AleksandreKalandadze/GateWay_STM32/GateWay_ver_2_3/Datasheets/POE pinout.png

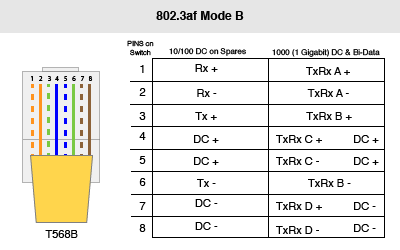
GateWay_ver_2_3/Datasheets/POE pinout.png
