AleksandreKalandadze/GateWay_STM32/GateWay_ver_2_3/Datasheets/W5500-Schematics.png

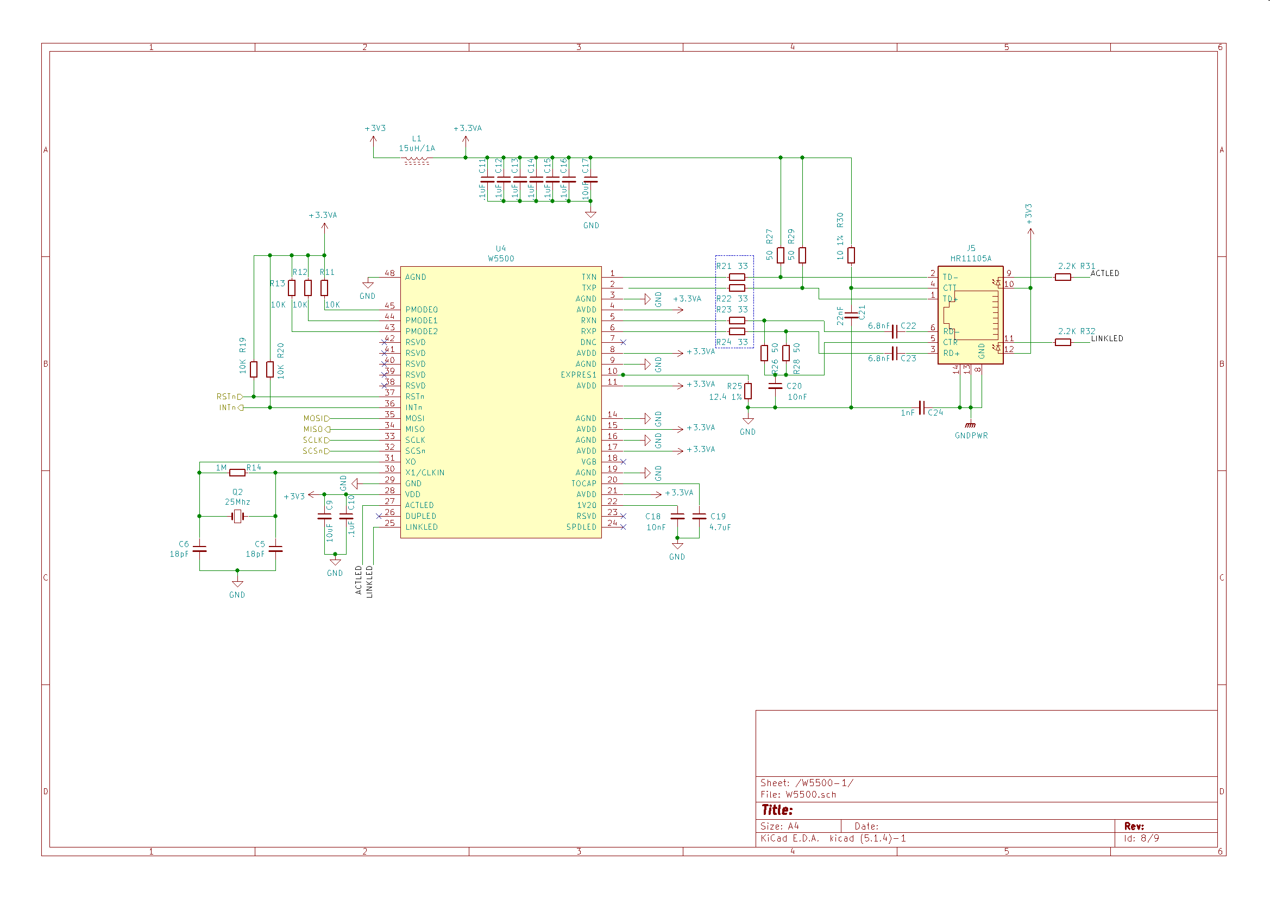
GateWay_ver_2_3/Datasheets/W5500-Schematics.png
