AleksandreKalandadze/GateWay_STM32/GateWay_ver_2_3/Parts/parts.xlsx

v AE1, AE2 | Antenna_Shield | Connector_Coaxial:SMA_Amphenol_901-144_Vertical
AE1 | Antenna_Shield | Connector_Coaxial:SMA_Amphenol_901-144_Vertical
AE2 | Antenna_Shield | Connector_Coaxial:SMA_Amphenol_901-144_Vertical
> C1-C5, C8, C17, C19-C22, C24-C27, C30, C31 | 100uF | Capacitor_SMD:C_1210_3225Metric
> C10, C50, C76, C83, C92 | 4.7uF | Capacitor_SMD:C_0805_2012Metric
C11 | 100uF tant | Capacitor_Tantalum_SMD:CP_EIA-3216-18_Kemet-A
> C7, C9, C12, C13, C16, C29, C32-C35, C38, C40, C43-C46, C48, C51, C52, C54, C56, C64, C65, C68-C73, C75, C79, C84-C90, C93-C96, C99, C100 | 0.1uF | Capacitor_SMD:C_0603_1608Metric
> C14, C15, C42, C47, C49, C53, C74, C78 | 0.01uF | Capacitor_SMD:C_0603_1608Metric
> C18, C23, C28, C36, C37, C67 | 22pF | Capacitor_SMD:C_0603_1608Metric
> C39, C41 | 2.2uF | Capacitor_SMD:C_0805_2012Metric
> C61, C62 | 10pF | Capacitor_SMD:C_0603_1608Metric
C63 | 1.5F | Capacitor_THT:C_Rect_L7.5mm_W6.5mm_P5.00mm
C66 | 18pF | Capacitor_SMD:C_0603_1608Metric
> C80, C81 | 6.8nF | Capacitor_SMD:C_0603_1608Metric
> C57, C77, C82 | 10uF | Capacitor_SMD:C_0805_2012Metric
C91 | 22nF | Capacitor_SMD:C_0603_1608Metric
D3 | MMBZ5242BLT3G | Package_TO_SOT_SMD:SOT-23
D7 | SMF15C | Package_TO_SOT_SMD:SOT-363_SC-70-6_Handsoldering
> D1, D8 | SMAJ5.0CA | Diode_SMD:D_SMA
> D6, D9-D17, D22 | LED_GREEN | LED_SMD:LED_0603_1608Metric
> D4, D5, D18, D19 | 1N5819 | Footprint:SOD-323
D20 | SM712_SOT23 | Package_TO_SOT_SMD:SOT-23
> D2, D21 | LED_RED | LED_SMD:LED_0603_1608Metric
J1 | DC-Jack_2.5x5.5 | Footprint:DC_Jack
J2 | SIM_Card | Footprint:SIM_Card_Holder_Molex
> J3, J4 | Conn_01x04 | Connector_PinHeader_1.27mm:PinHeader_1x04_P1.27mm_Vertical
J5 | Micro_SD_Card | Footprint:SD_Card_Holder_1
J6 | Conn_02x10_Odd_Even | Connector_IDC:IDC-Header_2x10_P2.54mm_Vertical
J7 | HR911105A | Footprint:HANRUN_HR911105A
> J8-J10 | RJ45_LED_Shielded | Connector_RJ:RJ45_Amphenol_RJHSE538X
J11 | Conn_01x05 | Footprint:XH2.54_4P_SMD
J12 | USB_B_Mini | Connector_USB:USB_Mini-B_Lumberg_2486_01_Horizontal
L1 | 4.7uH | Footprint:CD43
L2 | 6.8uH | Footprint:CD43
L3 | 47nH | Inductor_SMD:L_0805_2012Metric
L4 | 15uH | Resistor_SMD:R_0603_1608Metric
> Q1, Q4 | AO3400 | Package_TO_SOT_SMD:SOT-23
Q2 | DMP3013SFV | Package_SON:Diodes_PowerDI3333-8
Q3 | MMBT3904 | Package_TO_SOT_SMD:SOT-23
R12 | 100k | Resistor_SMD:R_0603_1608Metric
> R4, R13, R14 | 47k | Resistor_SMD:R_0603_1608Metric
> R15, R18 | 62k | Resistor_SMD:R_0603_1608Metric
R16 | 18k | Resistor_SMD:R_0603_1608Metric
R17 | 1.6k | Resistor_SMD:R_0603_1608Metric
> R5, R19 | 12k | Resistor_SMD:R_0603_1608Metric
> R21-R23 | 22R | Resistor_SMD:R_0603_1608Metric
> R10, R25-R29, R31, R55, R56, R61, R65, R72, R73, R81, R82 | 10k | Resistor_SMD:R_0603_1608Metric
R32 | 4.7 | Resistor_SMD:R_0603_1608Metric
> R6, R20, R24, R33, R68, R70 | 510R | Resistor_SMD:R_0603_1608Metric
R42 | 200R | Resistor_SMD:R_1206_3216Metric
> R1-R3, R7-R9, R11, R44, R46 | 4.7k | Resistor_SMD:R_0603_1608Metric
R47 | 1M | Resistor_SMD:R_0603_1608Metric
> R51-R54 | 33R | Resistor_SMD:R_0603_1608Metric
> R57-R60 | 49R | Resistor_SMD:R_0603_1608Metric
R62 | 12.4k 1% | Resistor_SMD:R_0603_1608Metric
> R30, R34-R41, R43, R45, R48-R50, R63, R66, R67, R71, R74-R80 | 1k | Resistor_SMD:R_0603_1608Metric
R64 | 10R | Resistor_SMD:R_0603_1608Metric
R69 | 120R | Resistor_SMD:R_0603_1608Metric
> SW1, SW2 | SW_Push | Button_Switch_SMD:SW_SPST_CK_RS282G05A3
> U1, U2 | RT8259 | Package_TO_SOT_SMD:SOT-23-6_Handsoldering
U3 | MIC29302WU | Package_TO_SOT_SMD:TO-263-5_TabPin3
U4 | ESP32-WROOM-32D | Footprint:ESP32-WROOM-32D
U5 | SIM7600E-H | Footprint:SIM7600E-H
U6 | HC-05 | Footprint:HC-05
U7 | STM32F407VETx | Package_QFP:LQFP-100_14x14mm_P0.5mm
U8 | PCF85063AT | Package_SO:SOIC-8_3.9x4.9mm_P1.27mm
U9 | CAT24C256 | Package_SO:SOIC-8_3.9x4.9mm_P1.27mm
U10 | TMP100 | Package_TO_SOT_SMD:SOT-23-6
U11 | W5500 | Package_QFP:LQFP-48_7x7mm_P0.5mm
U12 | SN74LV4052APW | Package_SO:TSSOP-16_4.4x5mm_P0.65mm
U13 | MAX3232 | Package_SO:SOP-16_3.9x9.9mm_P1.27mm
U14 | FT232RL | Package_SO:SSOP-28_5.3x10.2mm_P0.65mm
U15 | MAX3485 | Package_SO:SOIC-8_3.9x4.9mm_P1.27mm
U16 | TPD4EUSB30 | Package_SON:USON-10_2.5x1.0mm_P0.5mm
Y1 | 8mhz | Footprint:Crystal_smd_3225
Y2 | Crystal_GND23 | Crystal:Crystal_SMD_SeikoEpson_MC306-4Pin_8.0x3.2mm
Y3 | 25mhz | Footprint:Crystal_smd_3225
