AleksandreKalandadze/GateWay_STM32/GateWay_ver_2_3/PCB/Gateway_STM32_ver_2_3/COM PORT & BLE.kicad_sch

## KiCad design GateWay_ver_2_3/PCB/Gateway_STM32_ver_2_3/COM PORT & BLE.kicad_sch (2022-05-21)

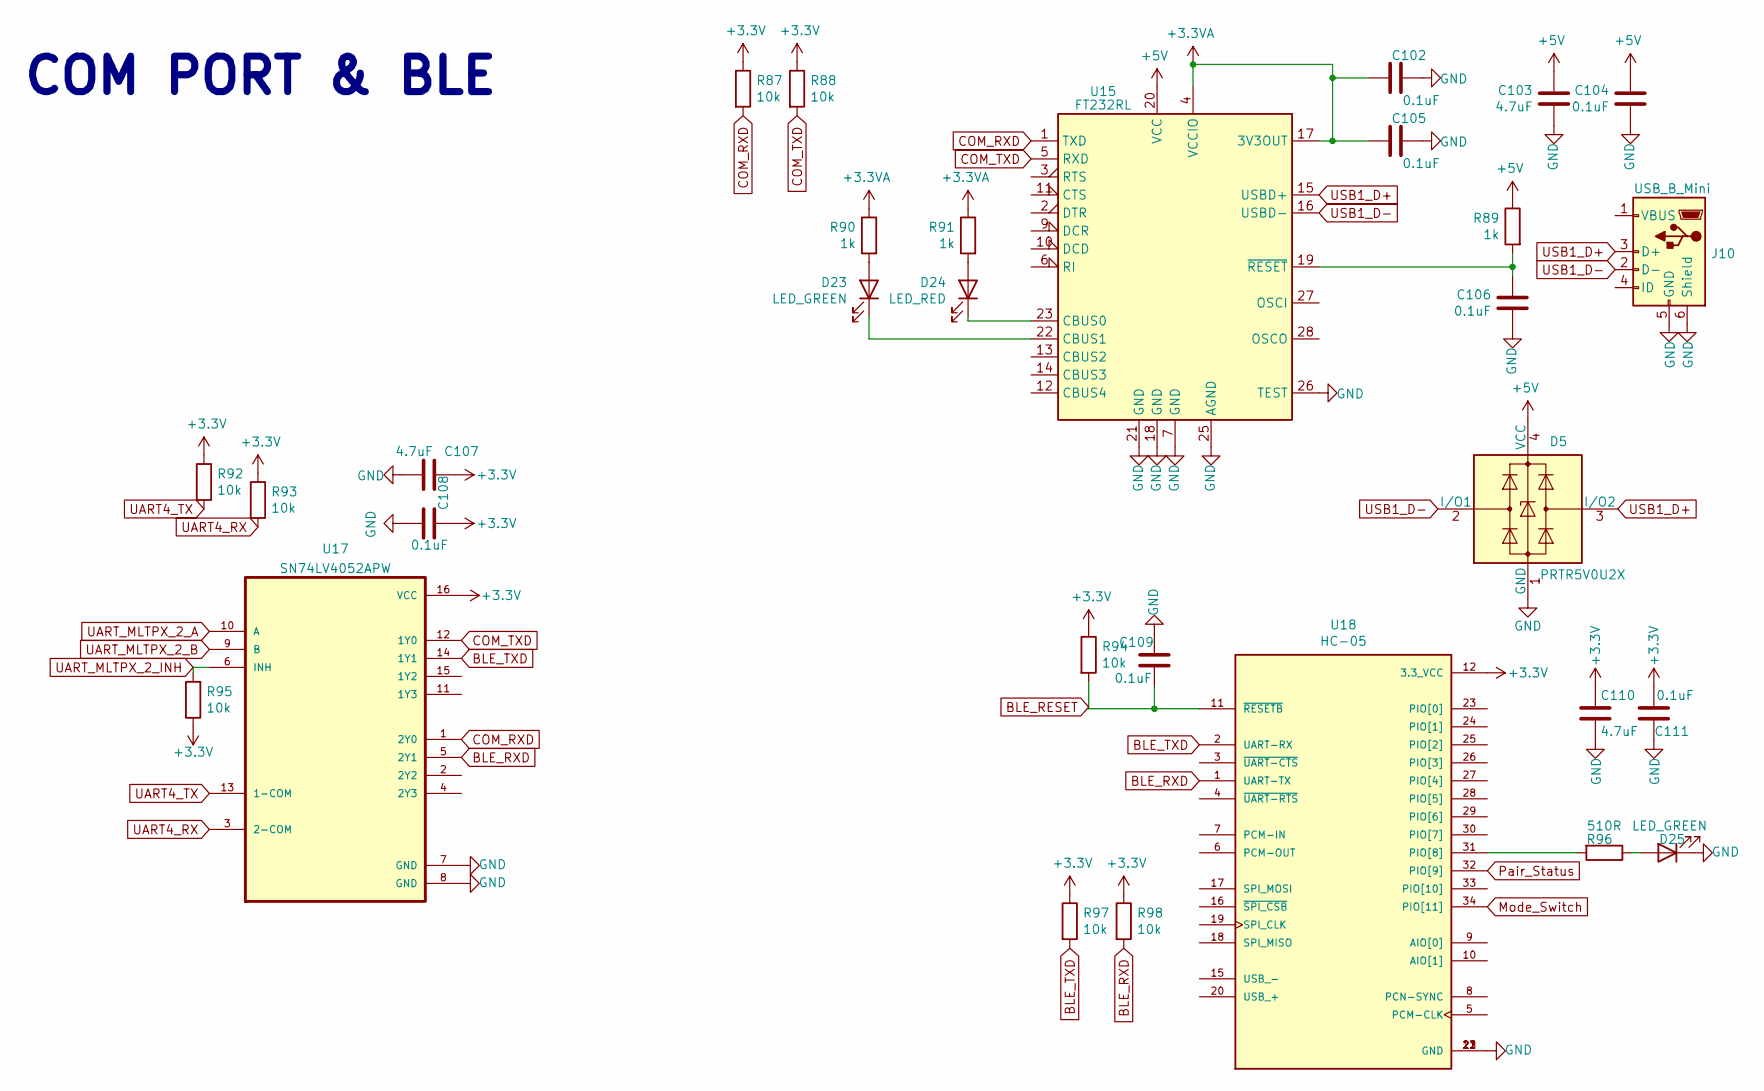
[picture p15: schematic COM PORT & BLE.kicad_sch]

Parts:
C102, C104, C105, C106, C108, C109, C111: 0.1uF; C_0603_1608Metric
C103, C107, C110: 4.7uF; C_0805_2012Metric
D5: PRTR5V0U2X; SOT-143
D23, D25: LED_GREEN; LED_0603_1608Metric
D24: LED_RED; LED_0603_1608Metric
J10: USB_B_Mini; USB_Mini-B_Lumberg_2486_01_Horizontal
R87, R88, R92, R93, R94, R95, R97, R98: 10k; R_0603_1608Metric
R89, R90, R91: 1k; R_0603_1608Metric
R96: 510R; R_0603_1608Metric
U15: FT232RL; SSOP-28_5.3x10.2mm_P0.65mm
U17: SN74LV4052APW; TSSOP-16_4.4x5mm_P0.65mm
U18: HC-05

Connections:
+3.3V: C107.1, C108.2, C110.1, C111.2, R87.1, R88.1, R92.1, R93.1, R94.1, R95.1, R97.1, R98.1, U17.16 (VCC), U18.12 (3.3_VCC)
+3.3VA: C102.1, C105.1, R90.1, R91.1, U15.4 (VCCIO), U15.17 (3V3OUT)
+5V: C103.1, C104.1, D5.4 (VCC), R89.1, U15.20 (VCC)
BLE_RESET: C109.2, R94.2, U18.11 (~RESETB)
BLE_RXD: R98.2, U17.5 (2Y1), U18.1 (UART-TX)
BLE_TXD: R97.2, U17.14 (1Y1), U18.2 (UART-RX)
COM_RXD: R87.2, U15.1 (TXD), U17.1 (2Y0)
COM_TXD: R88.2, U15.5 (RXD), U17.12 (1Y0)
GND: C102.2, C103.2, C104.2, C105.2, C106.2, C107.2, C108.1, C109.1, C110.2, C111.1, D5.1 (GND), D25.1 (K), J10.5 (GND), J10.6 (Shield), U15.7 (GND), U15.18 (GND), U15.21 (GND), U15.25 (AGND), U15.26 (TEST), U17.7 (GND), U17.8 (GND), U18.13 (GND), U18.21 (GND), U18.22 (GND)
Mode_Switch: U18.34 (PIO[11])
unnamed: C106.1, R89.2, U15.19 (~RESET)
unnamed: D23.1 (K), U15.22 (CBUS1)
unnamed: D23.2 (A), R90.2
unnamed: D24.1 (K), U15.23 (CBUS0)
unnamed: D24.2 (A), R91.2
unnamed: D25.2 (A), R96.1
unnamed: R96.2, U18.31 (PIO[8])
Pair_Status: U18.32 (PIO[9])
UART4_RX: R93.2, U17.3 (2-COM)
UART4_TX: R92.2, U17.13 (1-COM)
UART_MLTPX_2_A: U17.10 (A)
UART_MLTPX_2_B: U17.9 (B)
UART_MLTPX_2_INH: R95.2, U17.6 (INH)
USB1_D+: D5.3 (I/O2), J10.3 (D+), U15.15 (USBD+)
USB1_D-: D5.2 (I/O1), J10.2 (D-), U15.16 (USBD-)

Notes on the sheet:
COM PORT & BLE
