AleksandreKalandadze/GateWay_STM32/GateWay_ver_2_3/PCB/Gateway_STM32_ver_2_3/COM PORT.kicad_sch

## KiCad design GateWay_ver_2_3/PCB/Gateway_STM32_ver_2_3/COM PORT.kicad_sch (2022-02-23)

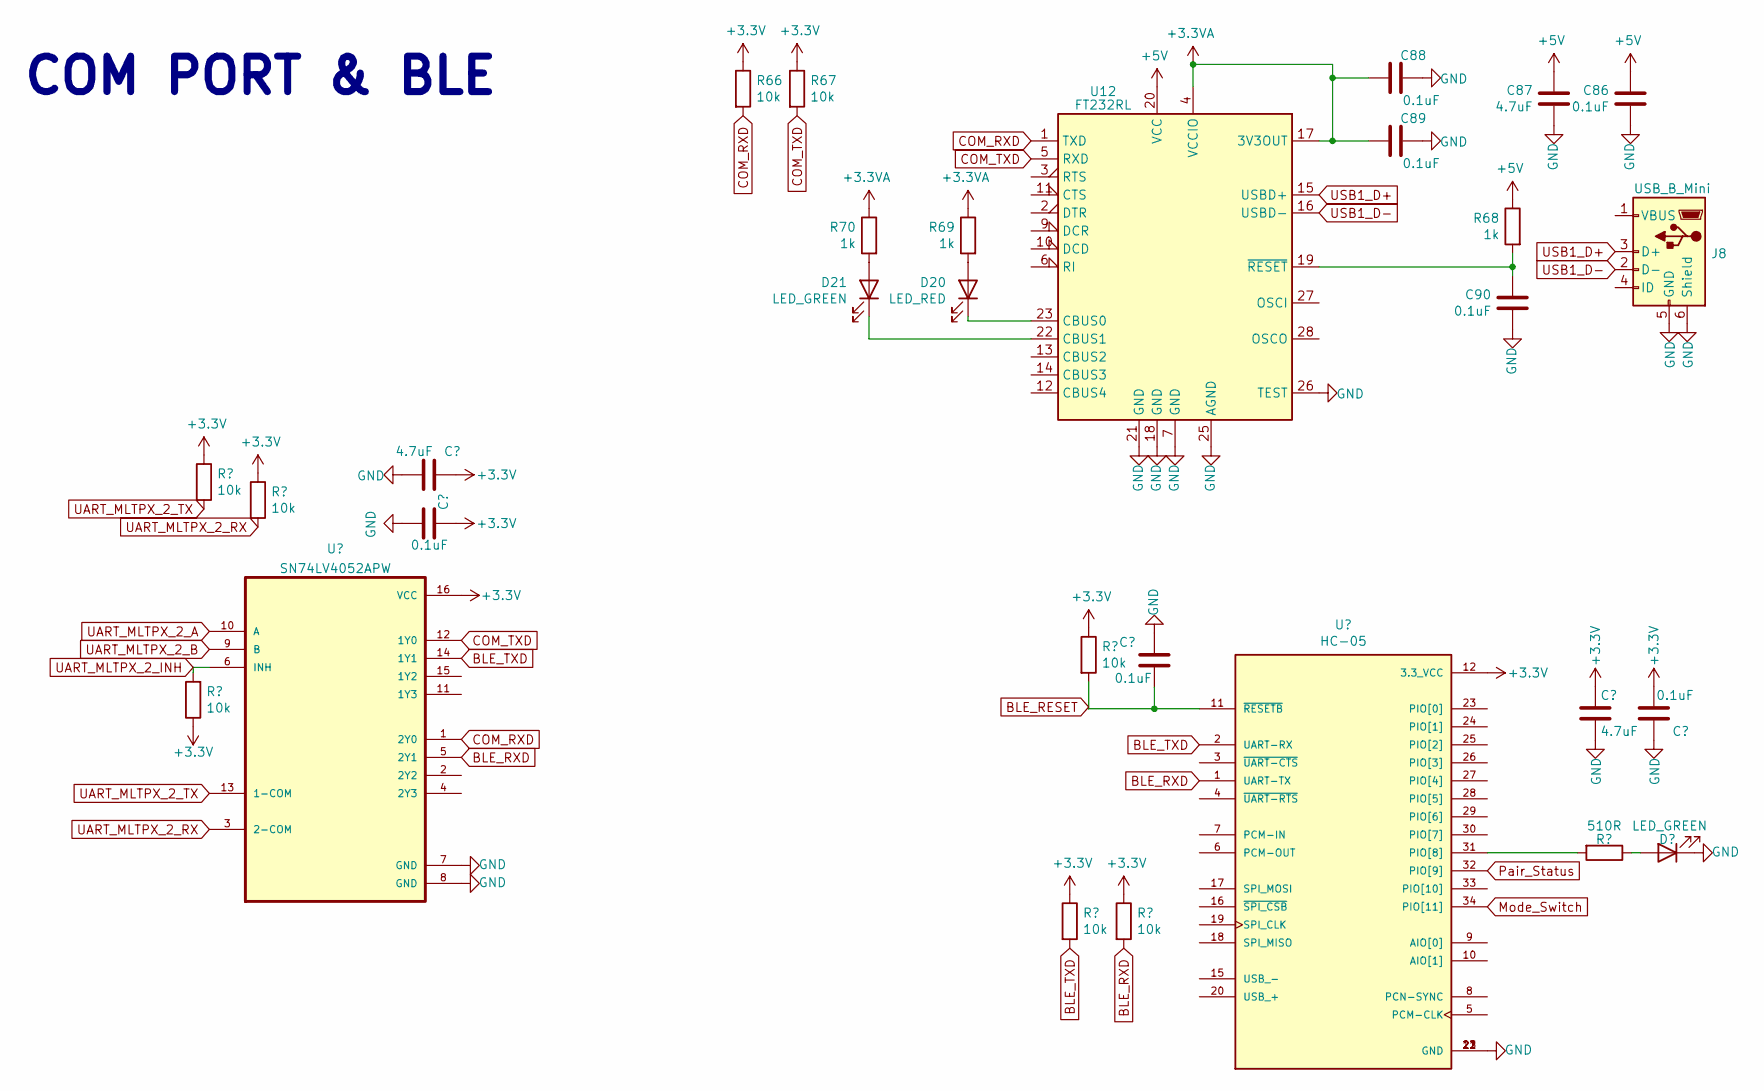
[picture p16: schematic COM PORT.kicad_sch]

Parts:
C86, C88, C89, C90: 0.1uF; C_0603_1608Metric
C87: 4.7uF; C_0805_2012Metric
D20: LED_RED; LED_0603_1608Metric
D21: LED_GREEN; LED_0603_1608Metric
J8: USB_B_Mini; USB_Mini-B_Lumberg_2486_01_Horizontal
R66, R67: 10k; R_0603_1608Metric
R68, R69, R70: 1k; R_0603_1608Metric
U12: FT232RL; SSOP-28_5.3x10.2mm_P0.65mm

Connections:
+3.3V: R66.1, R67.1
+3.3VA: C88.1, C89.1, R69.1, R70.1, U12.4 (VCCIO), U12.17 (3V3OUT)
+5V: C86.1, C87.1, R68.1, U12.20 (VCC)
COM_RXD: R66.2, U12.1 (TXD)
COM_TXD: R67.2, U12.5 (RXD)
GND: C86.2, C87.2, C88.2, C89.2, C90.2, J8.5 (GND), J8.6 (Shield), U12.7 (GND), U12.18 (GND), U12.21 (GND), U12.25 (AGND), U12.26 (TEST)
unnamed: C90.1, R68.2, U12.19 (~RESET)
unnamed: D20.1 (K), U12.23 (CBUS0)
unnamed: D20.2 (A), R69.2
unnamed: D21.1 (K), U12.22 (CBUS1)
unnamed: D21.2 (A), R70.2
USB1_D+: J8.3 (D+), U12.15 (USBD+)
USB1_D-: J8.2 (D-), U12.16 (USBD-)

Notes on the sheet:
COM PORT & BLE
