AleksandreKalandadze/GateWay_STM32/GateWay_ver_2_3/PCB/Gateway_STM32_ver_2_3/Display.kicad_sch

## KiCad design GateWay_ver_2_3/PCB/Gateway_STM32_ver_2_3/Display.kicad_sch (2022-04-11)

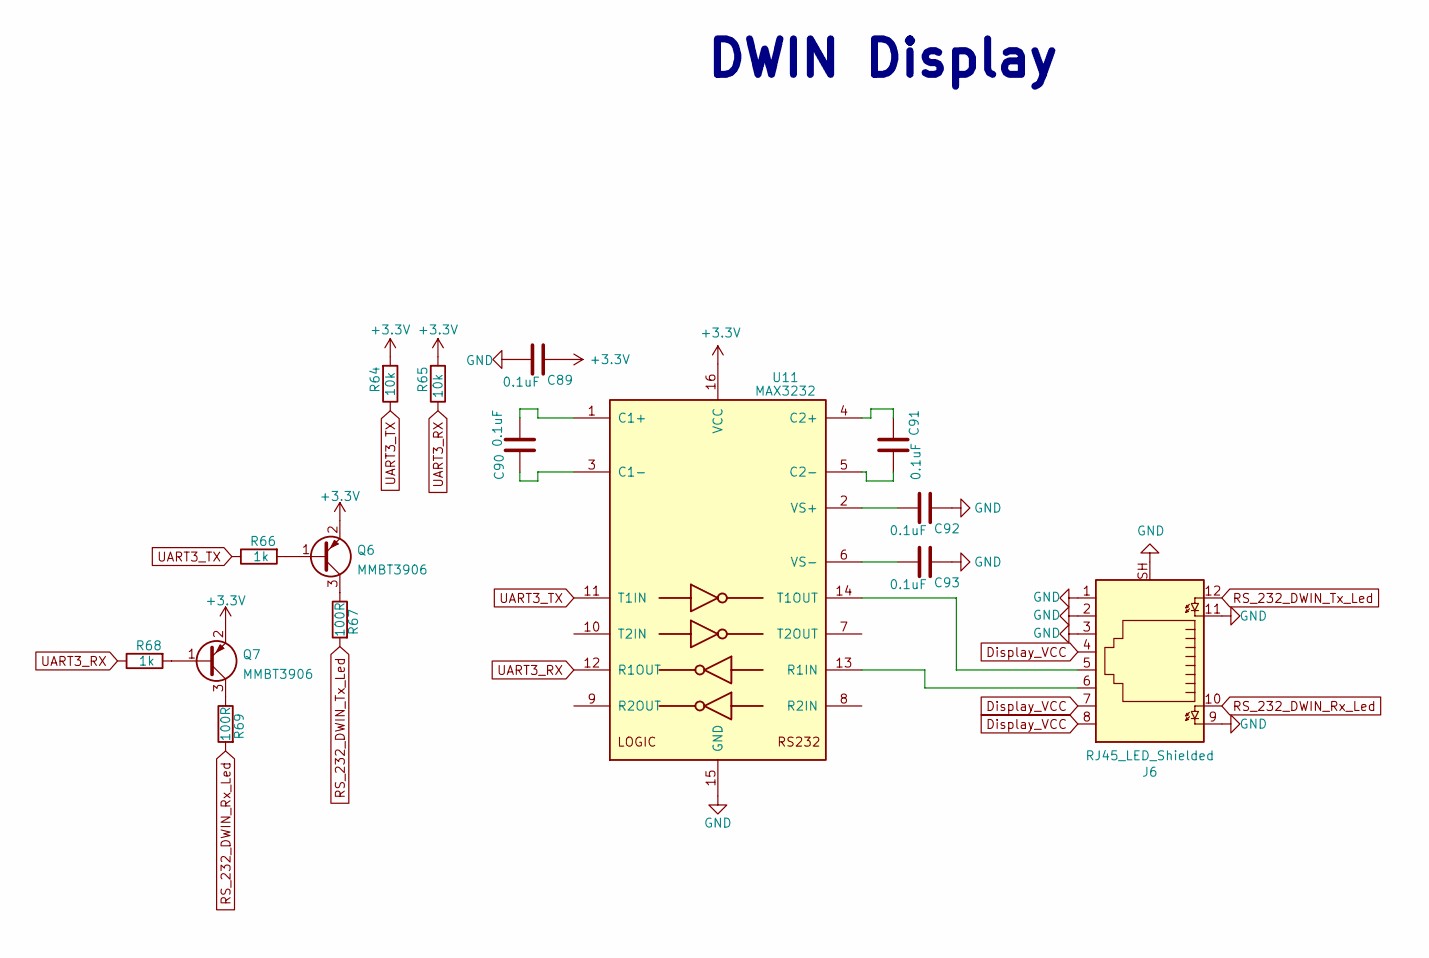
[picture p17: schematic Display.kicad_sch]

Parts:
C89, C90, C91, C92, C93: 0.1uF; C_0603_1608Metric
J6: RJ45_LED_Shielded; RJ45_Amphenol_RJHSE538X
Q6, Q7: MMBT3906; SOT-23
R64, R65: 10k; R_0603_1608Metric
R66, R68: 1k; R_0603_1608Metric
R67, R69: 100R; R_0603_1608Metric
U11: MAX3232; SOP-16_3.9x9.9mm_P1.27mm

Connections:
+3.3V: C89.1, Q6.2 (E), Q7.2 (E), R64.2, R65.2, U11.16 (VCC)
Display_VCC: J6.4, J6.7, J6.8
GND: C89.2, C92.1, C93.1, J6.1, J6.2, J6.3, J6.9, J6.11, J6.SH, U11.15 (GND)
unnamed: C90.1, U11.3 (C1-)
unnamed: C90.2, U11.1 (C1+)
unnamed: C91.1, U11.4 (C2+)
unnamed: C91.2, U11.5 (C2-)
unnamed: C92.2, U11.2 (VS+)
unnamed: C93.2, U11.6 (VS-)
unnamed: J6.5, U11.14 (T1OUT)
unnamed: J6.6, U11.13 (R1IN)
unnamed: Q6.1 (B), R66.2
unnamed: Q6.3 (C), R67.1
unnamed: Q7.1 (B), R68.2
unnamed: Q7.3 (C), R69.1
RS_232_DWIN_Rx_Led: J6.10, R69.2
RS_232_DWIN_Tx_Led: J6.12, R67.2
UART3_RX: R65.1, R68.1, U11.12 (R1OUT)
UART3_TX: R64.1, R66.1, U11.11 (T1IN)

Notes on the sheet:
DWIN Display
