AleksandreKalandadze/GateWay_STM32/GateWay_ver_2_3/PCB/Gateway_STM32_ver_2_3/EEPROM.kicad_sch

## KiCad design GateWay_ver_2_3/PCB/Gateway_STM32_ver_2_3/EEPROM.kicad_sch (2022-04-11)

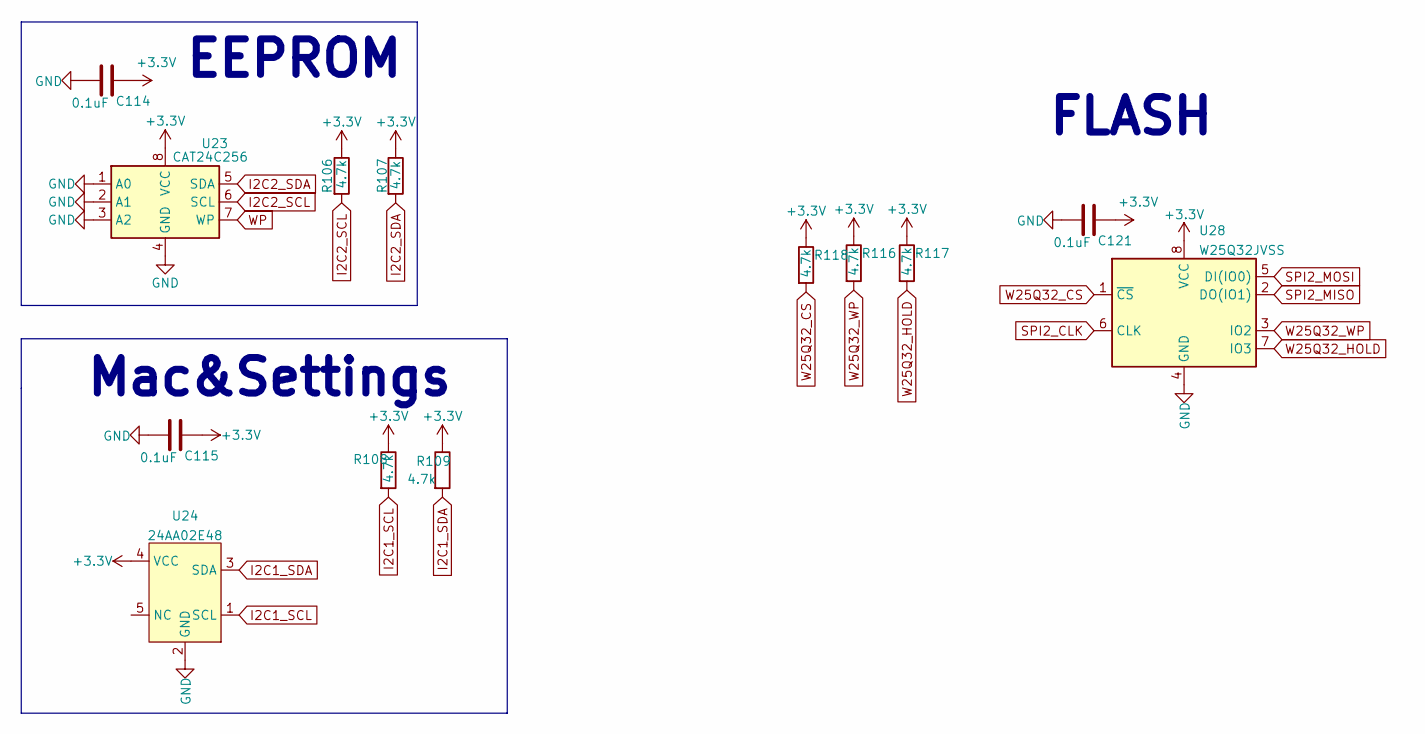
[picture p18: schematic EEPROM.kicad_sch]

Parts:
C114, C115, C121: 0.1uF; C_0603_1608Metric
R106, R107, R108, R109, R116, R117, R118: 4.7k; R_0603_1608Metric
U23: CAT24C256; SOIC-8_3.9x4.9mm_P1.27mm
U24: 24AA02E48; SOT-23-5
U28: W25Q32JVSS; SOIC-8_5.23x5.23mm_P1.27mm

Connections:
+3.3V: C114.1, C115.1, C121.1, R106.1, R107.1, R108.1, R109.1, R116.1, R117.1, R118.1, U23.8 (VCC), U24.4 (VCC), U28.8 (VCC)
GND: C114.2, C115.2, C121.2, U23.1 (A0), U23.2 (A1), U23.3 (A2), U23.4 (GND), U24.2 (GND), U28.4 (GND)
I2C1_SCL: R108.2, U24.1 (SCL)
I2C1_SDA: R109.2, U24.3 (SDA)
I2C2_SCL: R106.2, U23.6 (SCL)
I2C2_SDA: R107.2, U23.5 (SDA)
SPI2_CLK: U28.6 (CLK)
SPI2_MISO: U28.2 (DO(IO1))
SPI2_MOSI: U28.5 (DI(IO0))
W25Q32_CS: R118.2, U28.1 (~CS)
W25Q32_HOLD: R117.2, U28.7 (IO3)
W25Q32_WP: R116.2, U28.3 (IO2)
WP: U23.7 (WP)

Notes on the sheet:
FLASH
Mac&Settings
EEPROM
