AleksandreKalandadze/GateWay_STM32/GateWay_ver_2_3/PCB/Gateway_STM32_ver_2_3/Ethernet.kicad_sch

## KiCad design GateWay_ver_2_3/PCB/Gateway_STM32_ver_2_3/Ethernet.kicad_sch (2022-04-11)

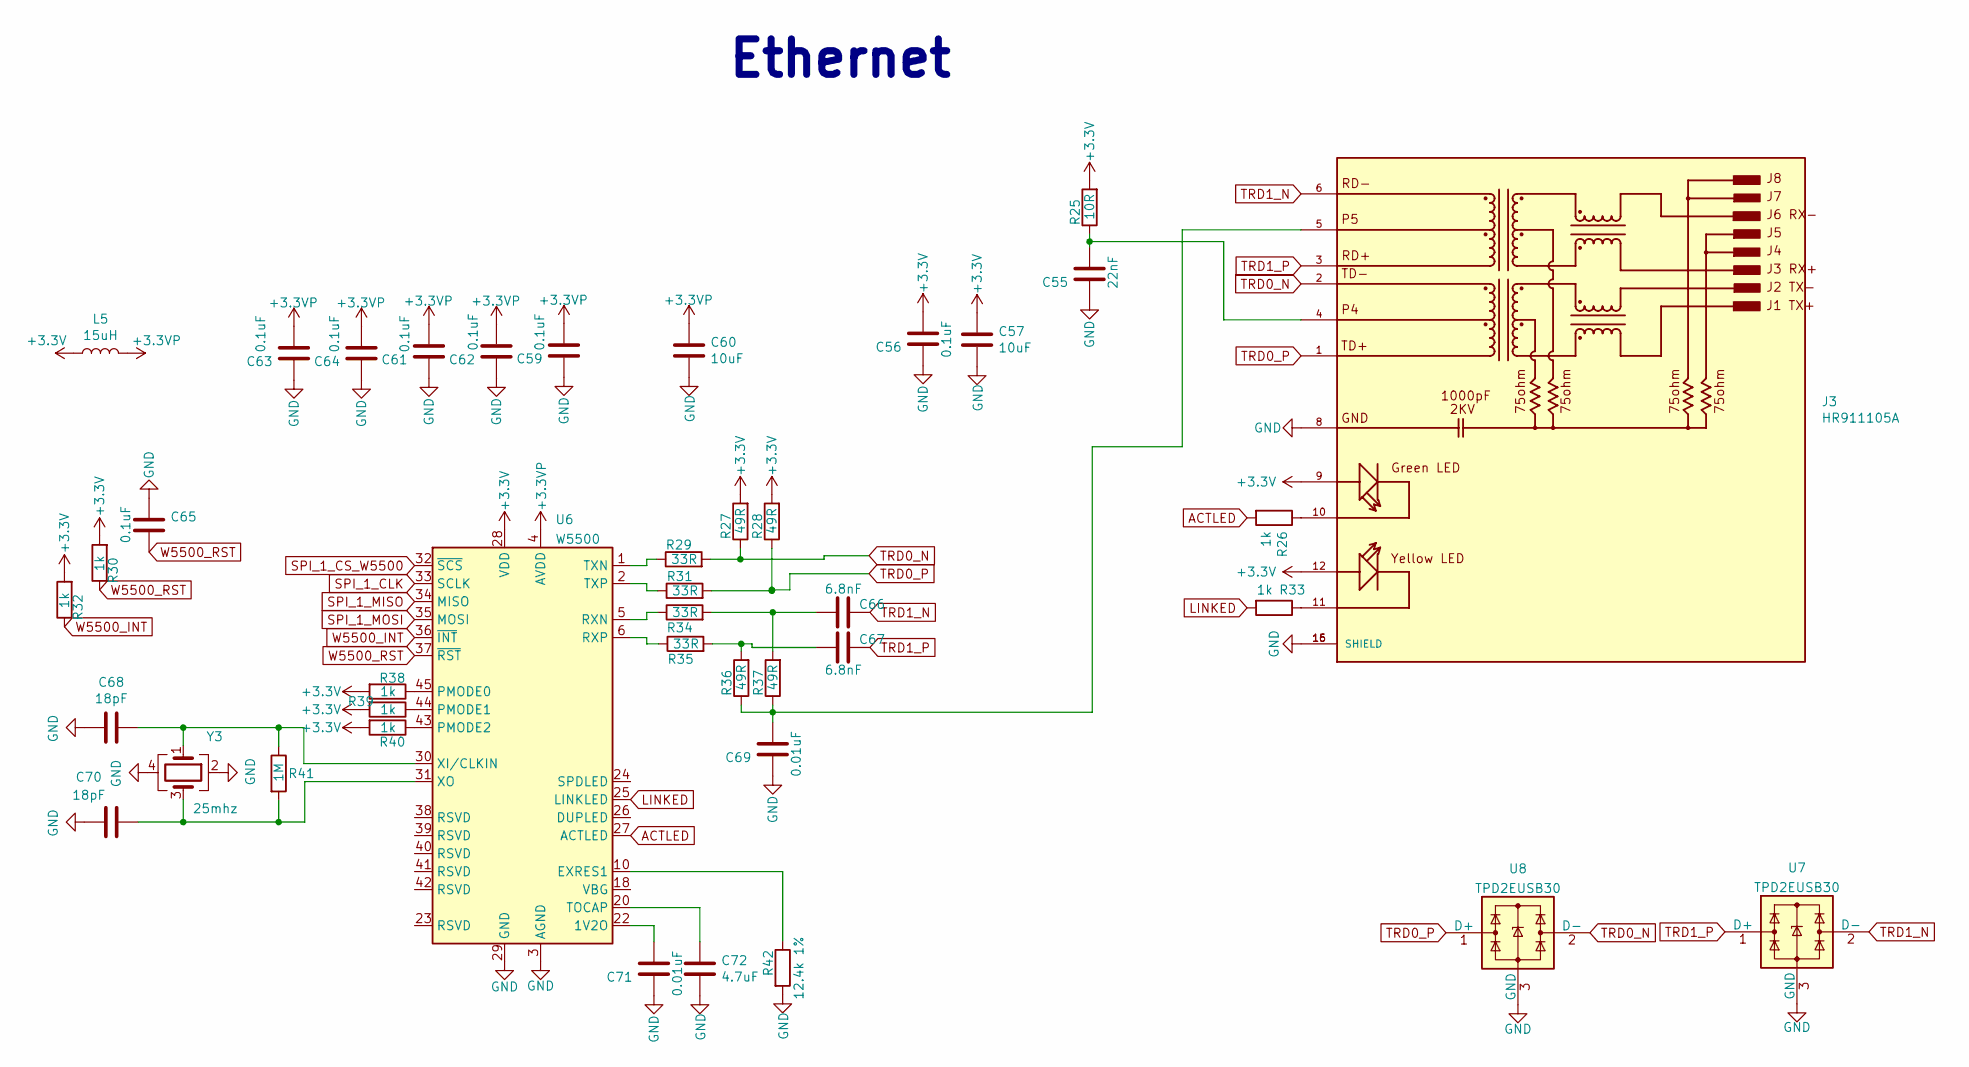
[picture p19: schematic Ethernet.kicad_sch]

Parts:
C55: 22nF; C_0603_1608Metric
C56, C59, C61, C62, C63, C64, C65: 0.1uF; C_0603_1608Metric
C57, C60: 10uF; C_0805_2012Metric
C66, C67: 6.8nF; C_0603_1608Metric
C68, C70: 18pF; C_0603_1608Metric
C69, C71: 0.01uF; C_0603_1608Metric
C72: 4.7uF; C_0805_2012Metric
J3: HR911105A; HANRUN_HR911105A; PARTREV A
L5: 15uH; R_0603_1608Metric
R25: 10R; R_0603_1608Metric
R26, R30, R32, R33, R38, R39, R40: 1k; R_0603_1608Metric
R27, R28, R36, R37: 49R; R_0603_1608Metric
R29, R31, R34, R35: 33R; R_0603_1608Metric
R41: 1M; R_0603_1608Metric
R42: 12.4k 1%; R_0603_1608Metric
U6: W5500; LQFP-48_7x7mm_P0.5mm
U7, U8: TPD2EUSB30; Texas_DRT-3
Y3: 25mhz; Crystal_smd_3225

Connections:
+3.3V: C56.2, C57.1, J3.9, J3.12, L5.1, R25.2, R27.2, R28.2, R30.2, R32.2, R38.2, R39.2, R40.2, U6.28 (VDD)
+3.3VP: C59.2, C60.1, C61.2, C62.2, C63.2, C64.2, L5.2, U6.4 (AVDD), U6.8 (AVDD), U6.11 (AVDD), U6.15 (AVDD), U6.17 (AVDD), U6.21 (AVDD)
ACTLED: R26.2, U6.27 (ACTLED)
GND: C55.1, C56.1, C57.2, C59.1, C60.2, C61.1, C62.1, C63.1, C64.1, C65.1, C68.1, C69.1, C70.1, C71.1, C72.2, J3.8, J3.15 (SHIELD), J3.16 (SHIELD), R42.2, U6.3 (AGND), U6.9 (AGND), U6.14 (AGND), U6.16 (AGND), U6.19 (AGND), U6.29 (GND), U6.48 (AGND), U7.3 (GND), U8.3 (GND), Y3.2, Y3.4
LINKED: R33.2, U6.25 (LINKLED)
unnamed: C55.2, J3.4, R25.1
unnamed: C66.2, R34.2, R37.2
unnamed: C67.2, R35.2, R36.2
unnamed: C68.2, R41.1, U6.30 (XI/CLKIN), Y3.1
unnamed: C69.2, J3.5, R36.1, R37.1
unnamed: C70.2, R41.2, U6.31 (XO), Y3.3
unnamed: C71.2, U6.22 (1V2O)
unnamed: C72.1, U6.20 (TOCAP)
unnamed: J3.10, R26.1
unnamed: J3.11, R33.1
unnamed: R29.1, U6.1 (TXN)
unnamed: R31.1, U6.2 (TXP)
unnamed: R34.1, U6.5 (RXN)
unnamed: R35.1, U6.6 (RXP)
unnamed: R38.1, U6.45 (PMODE0)
unnamed: R39.1, U6.44 (PMODE1)
unnamed: R40.1, U6.43 (PMODE2)
unnamed: R42.1, U6.10 (EXRES1)
SPI_1_CLK: U6.33 (SCLK)
SPI_1_CS_W5500: U6.32 (~SCS)
SPI_1_MISO: U6.34 (MISO)
SPI_1_MOSI: U6.35 (MOSI)
TRD0_N: J3.2, R27.1, R29.2, U8.2 (D-)
TRD0_P: J3.1, R28.1, R31.2, U8.1 (D+)
TRD1_N: C66.1, J3.6, U7.2 (D-)
TRD1_P: C67.1, J3.3, U7.1 (D+)
W5500_INT: R32.1, U6.36 (~INT)
W5500_RST: C65.2, R30.1, U6.37 (~RST)

Notes on the sheet:
Ethernet
