AleksandreKalandadze/GateWay_STM32/GateWay_ver_2_3/PCB/Gateway_STM32_ver_2_3/Gateway_STM32_ver_2_0.kicad_sch

## KiCad design GateWay_ver_2_3/PCB/Gateway_STM32_ver_2_3/Gateway_STM32_ver_2_0.kicad_sch (2022-05-21)

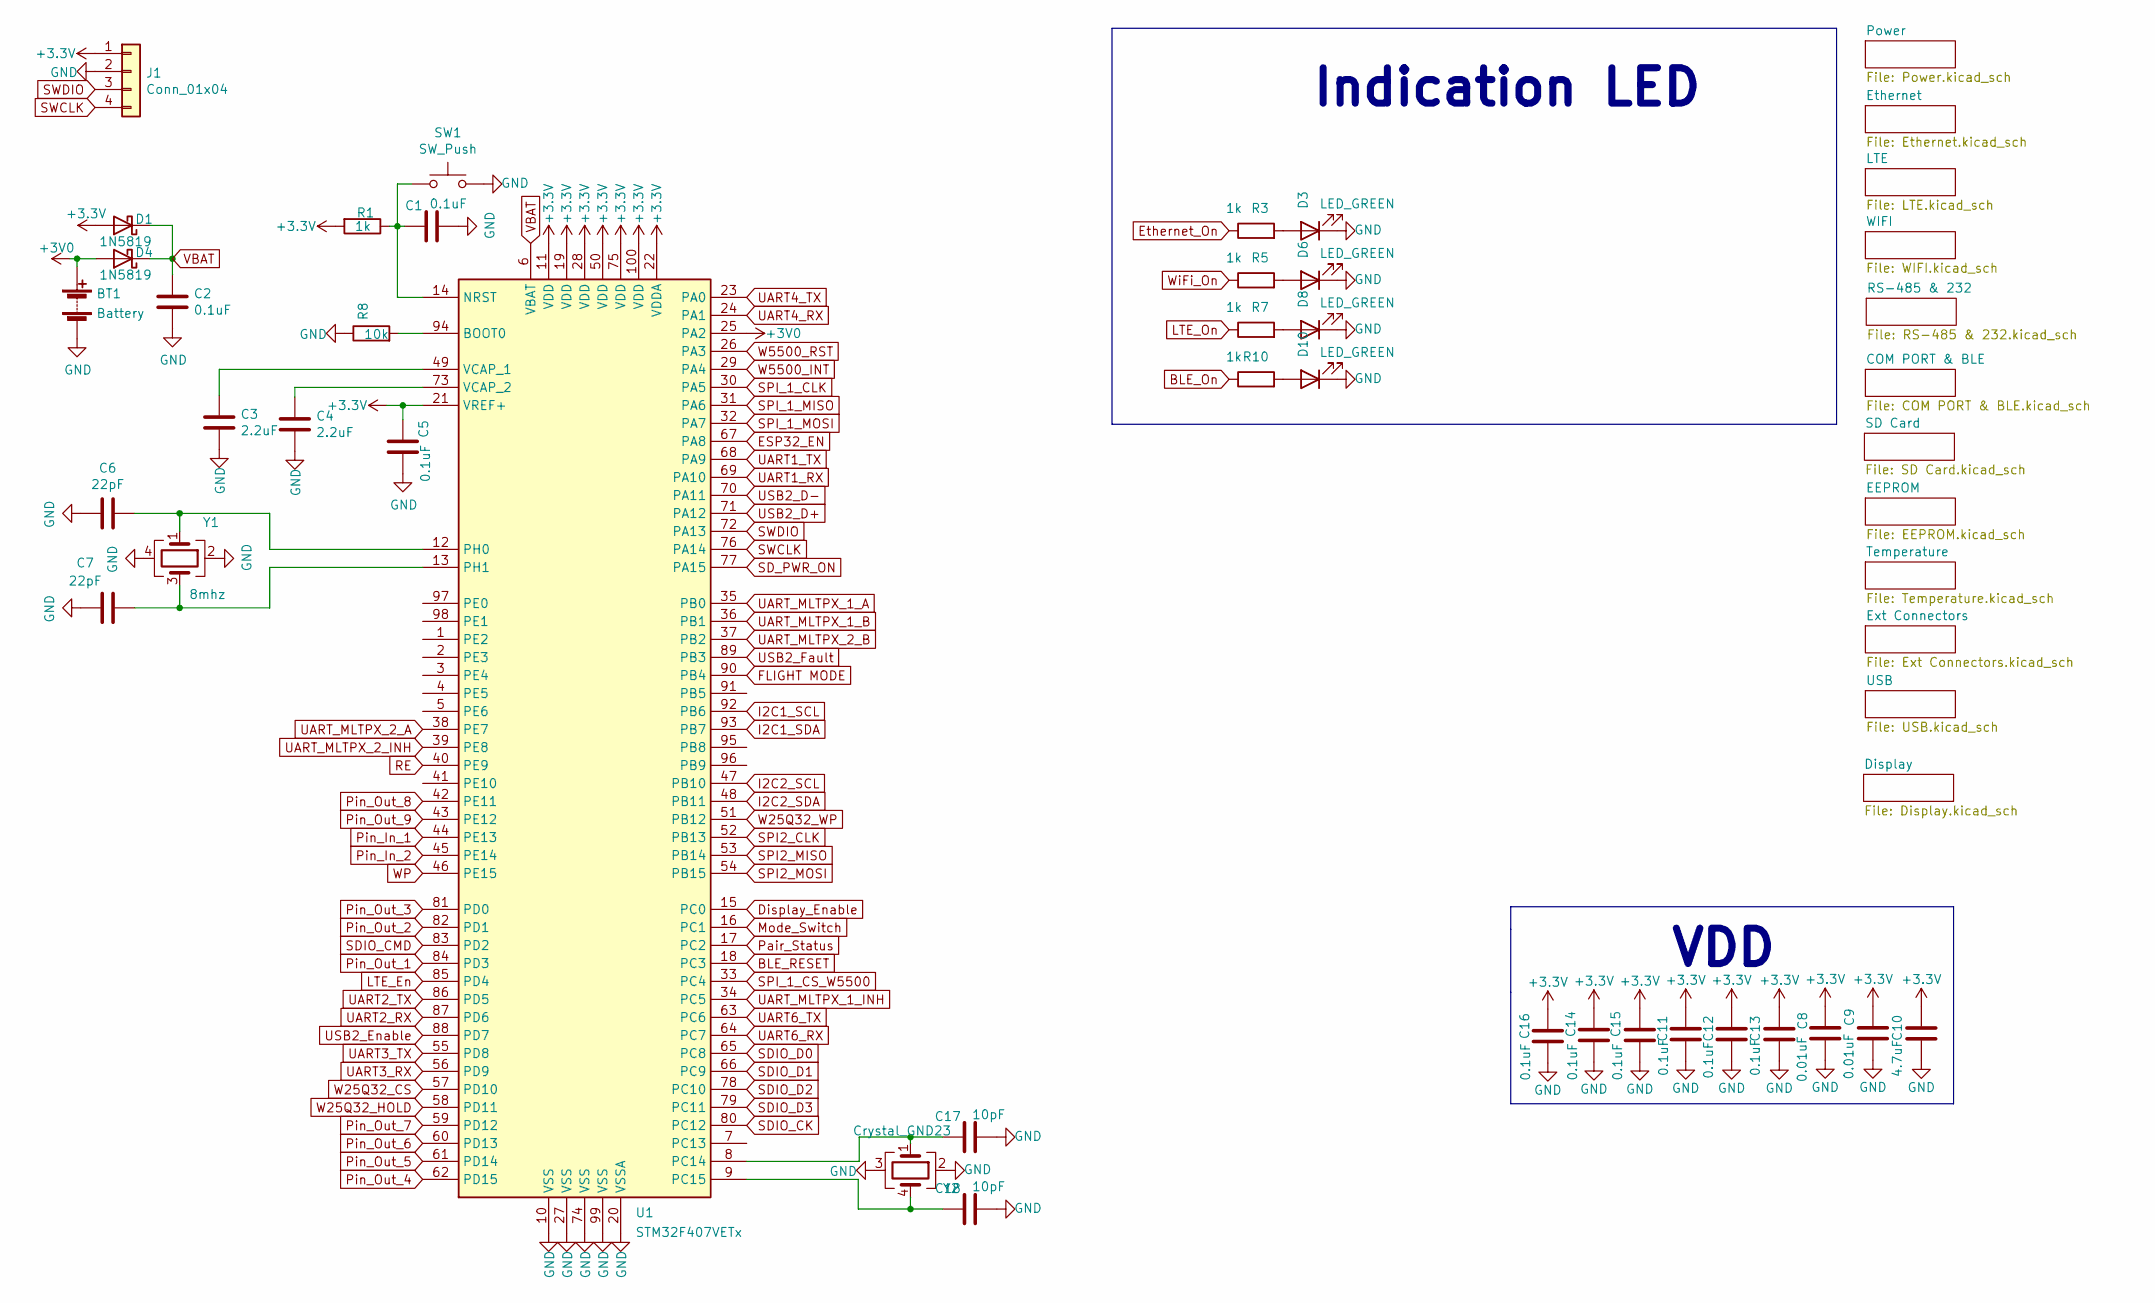
[picture p20: schematic Gateway_STM32_ver_2_0.kicad_sch]

Parts:
BT1: Battery; CR2032_Holder_Vertical
C1, C2, C5, C11, C12, C13, C14, C15, C16: 0.1uF; C_0603_1608Metric
C3, C4: 2.2uF; C_0805_2012Metric
C6, C7: 22pF; C_0603_1608Metric
C8, C9: 0.01uF; C_0603_1608Metric
C10: 4.7uF; C_0805_2012Metric
C17, C18: 10pF; C_0603_1608Metric
D1, D4: 1N5819; SOD-323
D3, D6, D8, D10: LED_GREEN; LED_0603_1608Metric
J1: Conn_01x04; PinHeader_1x04_P1.27mm_Vertical
R1, R3, R5, R7, R10: 1k; R_0603_1608Metric
R8: 10k; R_0603_1608Metric
SW1: SW_Push; SW_SPST_CK_RS282G05A3
U1: STM32F407VETx; LQFP-100_14x14mm_P0.5mm
Y1: 8mhz; Crystal_smd_3225
Y2: Crystal_GND23; Crystal_SMD_SeikoEpson_MC306-4Pin_8.0x3.2mm

Connections:
+3.3V: C5.1, C8.2, C9.2, C10.2, C11.2, C12.2, C13.2, C14.2, C15.2, C16.2, D1.2 (A), J1.1, R1.2, U1.11 (VDD), U1.19 (VDD), U1.21 (VREF+), U1.22 (VDDA), U1.28 (VDD), U1.50 (VDD), U1.75 (VDD), U1.100 (VDD)
+3V0: BT1.1 (+), D4.2 (A), U1.25 (PA2)
BLE_On: R10.1
BLE_RESET: U1.18 (PC3)
Display_Enable: U1.15 (PC0)
ESP32_EN: U1.67 (PA8)
Ethernet_On: R3.1
FLIGHT MODE: U1.90 (PB4)
GND: BT1.2 (-), C1.2, C2.2, C3.2, C4.2, C5.2, C6.1, C7.1, C8.1, C9.1, C10.1, C11.1, C12.1, C13.1, C14.1, C15.1, C16.1, C17.2, C18.2, D3.1 (K), D6.1 (K), D8.1 (K), D10.1 (K), J1.2, R8.1, SW1.2, U1.10 (VSS), U1.20 (VSSA), U1.27 (VSS), U1.74 (VSS), U1.99 (VSS), Y1.2, Y1.4, Y2.2, Y2.3
I2C1_SCL: U1.92 (PB6)
I2C1_SDA: U1.93 (PB7)
I2C2_SCL: U1.47 (PB10)
I2C2_SDA: U1.48 (PB11)
LTE_En: U1.85 (PD4)
LTE_On: R7.1
Mode_Switch: U1.16 (PC1)
unnamed: C1.1, R1.1, SW1.1, U1.14 (NRST)
unnamed: C3.1, U1.49 (VCAP_1)
unnamed: C4.1, U1.73 (VCAP_2)
unnamed: C6.2, U1.12 (PH0), Y1.1
unnamed: C7.2, U1.13 (PH1), Y1.3
unnamed: C17.1, U1.8 (PC14), Y2.1
unnamed: C18.1, U1.9 (PC15), Y2.4
unnamed: D3.2 (A), R3.2
unnamed: D6.2 (A), R5.2
unnamed: D8.2 (A), R7.2
unnamed: D10.2 (A), R10.2
unnamed: R8.2, U1.94 (BOOT0)
Pair_Status: U1.17 (PC2)
Pin_In_1: U1.44 (PE13)
Pin_In_2: U1.45 (PE14)
Pin_Out_1: U1.84 (PD3)
Pin_Out_2: U1.82 (PD1)
Pin_Out_3: U1.81 (PD0)
Pin_Out_4: U1.62 (PD15)
Pin_Out_5: U1.61 (PD14)
Pin_Out_6: U1.60 (PD13)
Pin_Out_7: U1.59 (PD12)
Pin_Out_8: U1.42 (PE11)
Pin_Out_9: U1.43 (PE12)
RE: U1.40 (PE9)
SDIO_CK: U1.80 (PC12)
SDIO_CMD: U1.83 (PD2)
SDIO_D0: U1.65 (PC8)
SDIO_D1: U1.66 (PC9)
SDIO_D2: U1.78 (PC10)
SDIO_D3: U1.79 (PC11)
SD_PWR_ON: U1.77 (PA15)
SPI2_CLK: U1.52 (PB13)
SPI2_MISO: U1.53 (PB14)
SPI2_MOSI: U1.54 (PB15)
SPI_1_CLK: U1.30 (PA5)
SPI_1_CS_W5500: U1.33 (PC4)
SPI_1_MISO: U1.31 (PA6)
SPI_1_MOSI: U1.32 (PA7)
SWCLK: J1.4, U1.76 (PA14)
SWDIO: J1.3, U1.72 (PA13)
UART1_RX: U1.69 (PA10)
UART1_TX: U1.68 (PA9)
UART2_RX: U1.87 (PD6)
UART2_TX: U1.86 (PD5)
UART3_RX: U1.56 (PD9)
UART3_TX: U1.55 (PD8)
UART4_RX: U1.24 (PA1)
UART4_TX: U1.23 (PA0)
UART6_RX: U1.64 (PC7)
UART6_TX: U1.63 (PC6)
UART_MLTPX_1_A: U1.35 (PB0)
UART_MLTPX_1_B: U1.36 (PB1)
UART_MLTPX_1_INH: U1.34 (PC5)
UART_MLTPX_2_A: U1.38 (PE7)
UART_MLTPX_2_B: U1.37 (PB2)
UART_MLTPX_2_INH: U1.39 (PE8)
USB2_D+: U1.71 (PA12)
USB2_D-: U1.70 (PA11)
USB2_Enable: U1.88 (PD7)
USB2_Fault: U1.89 (PB3)
VBAT: C2.1, D1.1 (K), D4.1 (K), U1.6 (VBAT)
W25Q32_CS: U1.57 (PD10)
W25Q32_HOLD: U1.58 (PD11)
W25Q32_WP: U1.51 (PB12)
W5500_INT: U1.29 (PA4)
W5500_RST: U1.26 (PA3)
WP: U1.46 (PE15)
WiFi_On: R5.1

Notes on the sheet:
VDD
Indication LED
