AleksandreKalandadze/GateWay_STM32/GateWay_ver_2_3/PCB/Gateway_STM32_ver_2_3/LTE.kicad_sch

## KiCad design GateWay_ver_2_3/PCB/Gateway_STM32_ver_2_3/LTE.kicad_sch (2022-04-11)

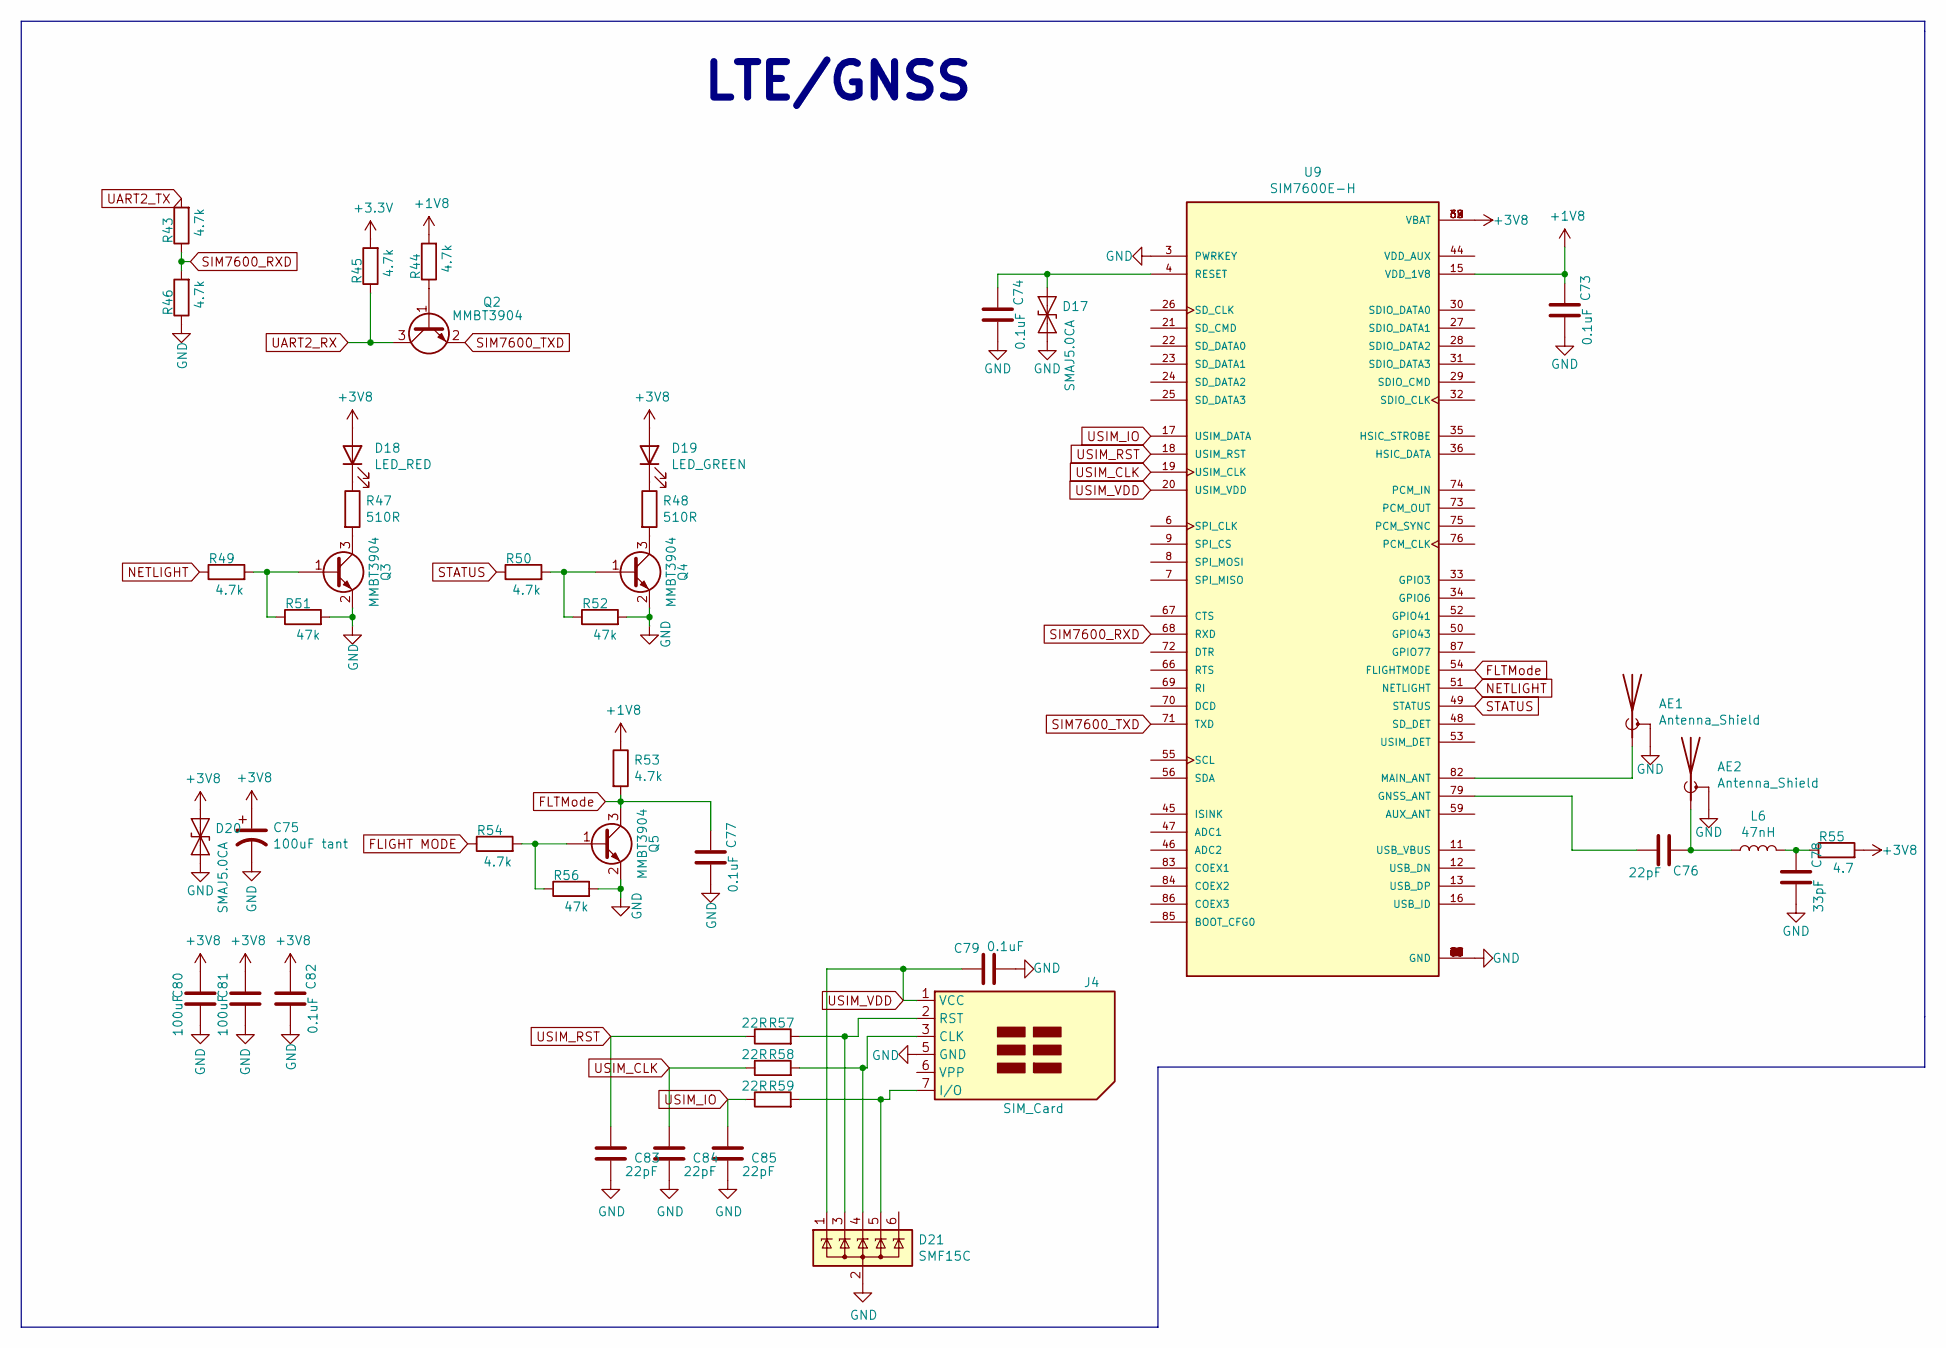
[picture p21: schematic LTE.kicad_sch]

Parts:
AE1, AE2: Antenna_Shield; SMA_Samtec_SMA-J-P-X-ST-EM1_EdgeMount
C73, C74, C77, C79, C82: 0.1uF; C_0603_1608Metric
C75: 100uF tant; CP_EIA-3216-18_Kemet-A
C76, C83, C84, C85: 22pF; C_0603_1608Metric
C78: 33pF; C_0603_1608Metric
C80, C81: 100uF; C_1210_3225Metric
D17, D20: SMAJ5.0CA; D_SMA
D18: LED_RED; LED_0603_1608Metric
D19: LED_GREEN; LED_0603_1608Metric
D21: SMF15C; SOT-363_SC-70-6
J4: SIM_Card; SIM_Card_Holder_Molex
L6: 47nH; L_0805_2012Metric
Q2, Q3, Q4, Q5: MMBT3904; SOT-23
R43, R44, R45, R46, R49, R50, R53, R54: 4.7k; R_0603_1608Metric
R47, R48: 510R; R_0603_1608Metric
R51, R52, R56: 47k; R_0603_1608Metric
R55: 4.7; R_0603_1608Metric
R57, R58, R59: 22R; R_0603_1608Metric
U9: SIM7600E-H

Connections:
+1V8: C73.1, R44.2, R53.1, U9.15 (VDD_1V8)
+3.3V: R45.2
+3V8: C75.1, C80.2, C81.2, C82.1, D18.2 (A), D19.2 (A), D20.1 (A1), R55.2, U9.38 (VBAT), U9.39 (VBAT), U9.62 (VBAT), U9.63 (VBAT)
FLIGHT MODE: R54.1
FLTMode: C77.1, Q5.3 (C), R53.2, U9.54 (FLIGHTMODE)
GND: AE1.2 (Shield), AE2.2 (Shield), C73.2, C74.2, C75.2, C77.2, C78.2, C79.2, C80.1, C81.1, C82.2, C83.2, C84.2, C85.2, D17.2 (A2), D20.2 (A2), D21.2 (A), J4.5 (GND), Q3.2 (E), Q4.2 (E), Q5.2 (E), R46.1, R51.2, R52.2, R56.2, U9.1 (GND), U9.2 (GND), U9.3 (PWRKEY), U9.5 (GND), U9.10 (GND), U9.14 (GND), U9.37 (GND), U9.40 (GND), U9.41 (GND), U9.43 (GND), U9.57 (GND), U9.58 (GND), U9.60 (GND), U9.61 (GND), U9.64 (GND), U9.65 (GND), U9.77 (GND), U9.78 (GND), U9.80 (GND), U9.81 (GND)
NETLIGHT: R49.1, U9.51 (NETLIGHT)
unnamed: AE1.1 (A), U9.82 (MAIN_ANT)
unnamed: AE2.1 (A), C76.1, L6.1
unnamed: C74.1, D17.1 (A1), U9.4 (RESET)
unnamed: C76.2, U9.79 (GNSS_ANT)
unnamed: C78.1, L6.2, R55.1
unnamed: D18.1 (K), R47.1
unnamed: D19.1 (K), R48.1
unnamed: D21.3 (K), J4.2 (RST), R57.2
unnamed: D21.4 (K), J4.3 (CLK), R58.2
unnamed: D21.5 (K), J4.7 (I/O), R59.2
unnamed: Q2.1 (B), R44.1
unnamed: Q3.1 (B), R49.2, R51.1
unnamed: Q3.3 (C), R47.2
unnamed: Q4.1 (B), R50.2, R52.1
unnamed: Q4.3 (C), R48.2
unnamed: Q5.1 (B), R54.2, R56.1
SIM7600_RXD: R43.1, R46.2, U9.68 (RXD)
SIM7600_TXD: Q2.2 (E), U9.71 (TXD)
STATUS: R50.1, U9.49 (STATUS)
UART2_RX: Q2.3 (C), R45.1
UART2_TX: R43.2
USIM_CLK: C84.1, R58.1, U9.19 (USIM_CLK)
USIM_IO: C85.1, R59.1, U9.17 (USIM_DATA)
USIM_RST: C83.1, R57.1, U9.18 (USIM_RST)
USIM_VDD: C79.1, D21.1 (K), J4.1 (VCC), U9.20 (USIM_VDD)

Notes on the sheet:
LTE/GNSS
