AleksandreKalandadze/GateWay_STM32/GateWay_ver_2_3/PCB/Gateway_STM32_ver_2_3/Power.kicad_sch

## KiCad design GateWay_ver_2_3/PCB/Gateway_STM32_ver_2_3/Power.kicad_sch (2022-04-11)

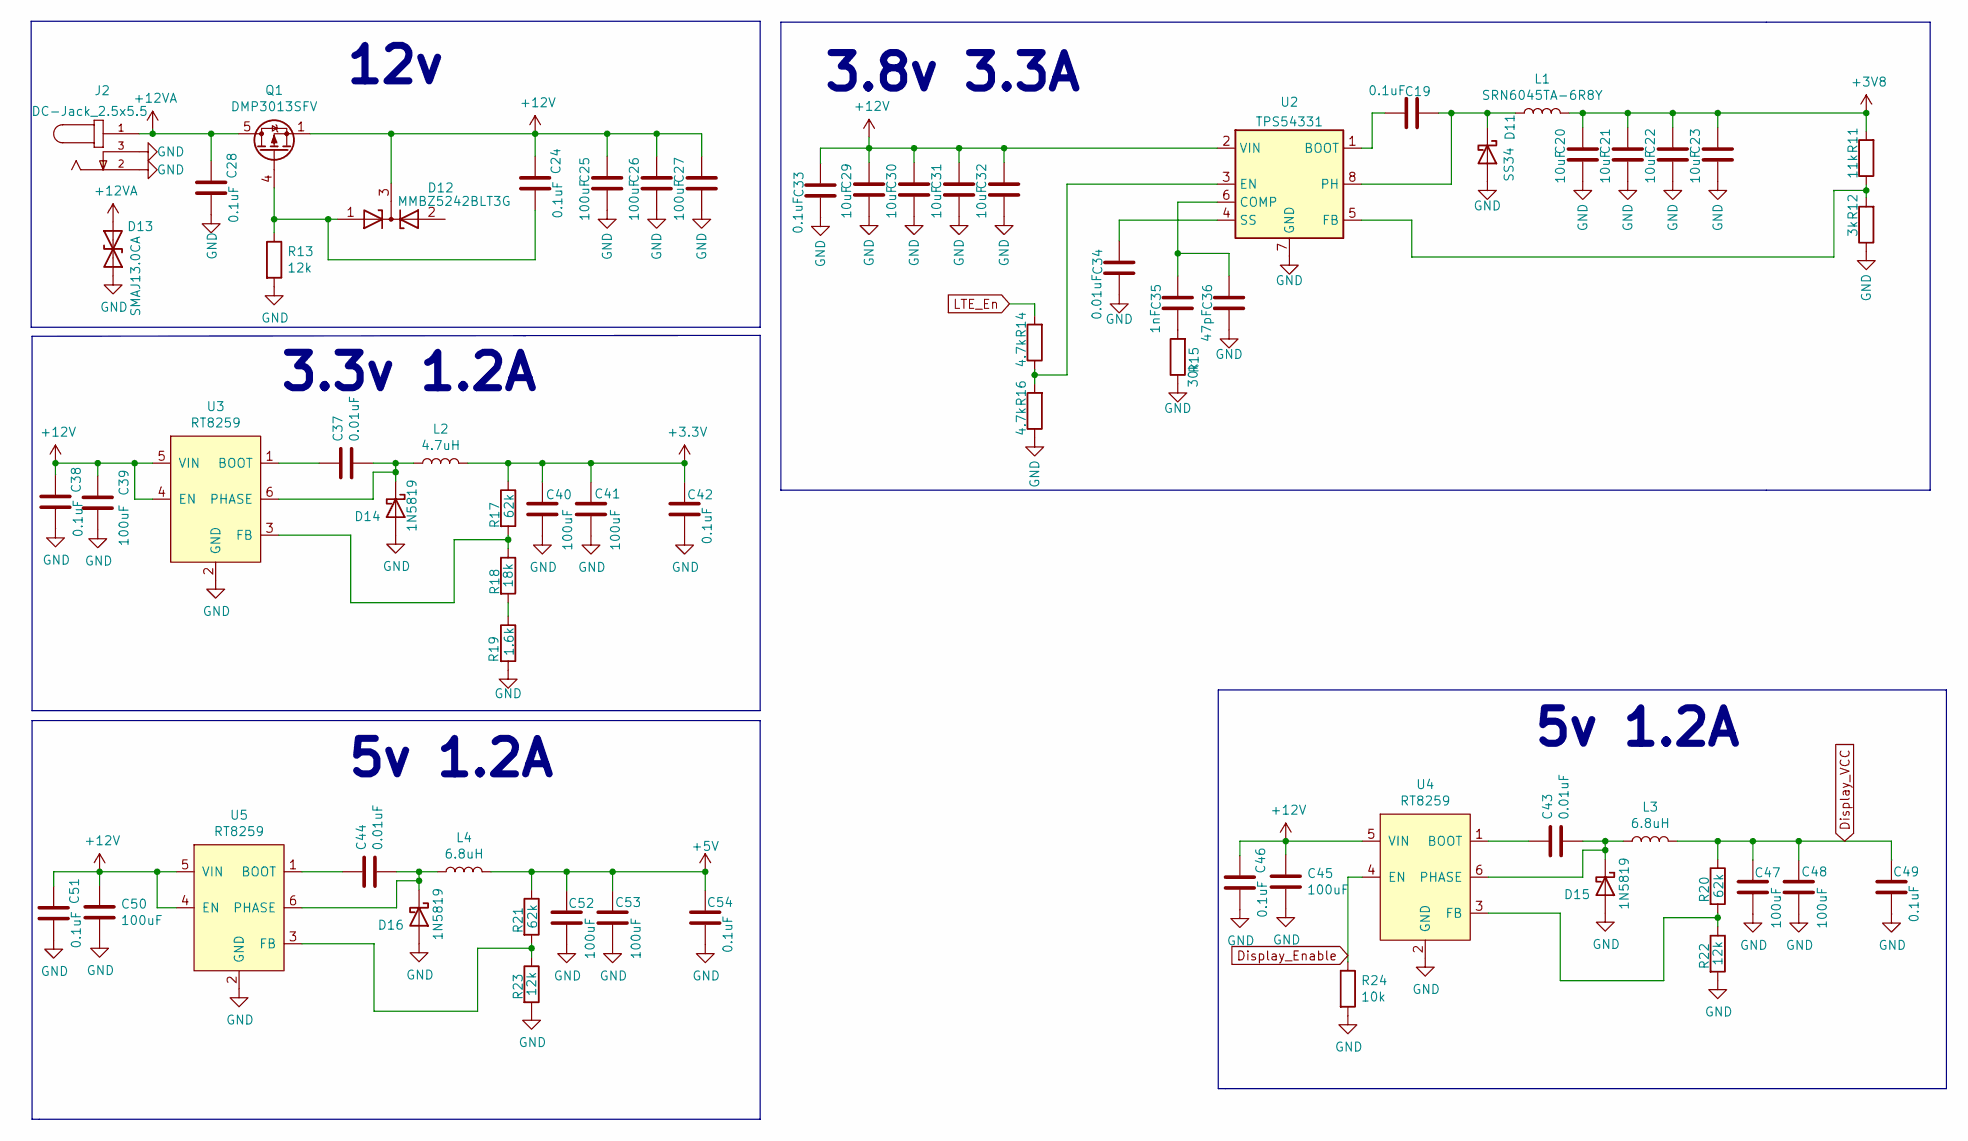
[picture p22: schematic Power.kicad_sch]

Parts:
C19, C24, C28, C33, C38, C42, C46, C49, C51, C54: 0.1uF; C_0603_1608Metric
C20, C21, C22, C23, C29, C30, C31, C32: 10uF; C_0805_2012Metric
C25, C26, C27, C39, C40, C41, C45, C47, C48, C50, C52, C53: 100uF; C_1210_3225Metric
C34, C37, C43, C44: 0.01uF; C_0603_1608Metric
C35: 1nF; C_0603_1608Metric
C36: 47pF; C_0603_1608Metric
D11: SS34; D_SMA
D12: MMBZ5242BLT3G; SOT-23
D13: SMAJ13.0CA; D_SMA
D14, D15, D16: 1N5819; SOD-323
J2: DC-Jack_2.5x5.5; DC_Jack; PARTREV 1.02
L1: SRN6045TA-6R8Y; L_Bourns_SRN6045TA
L2: 4.7uH; CD43
L3, L4: 6.8uH; CD43
Q1: DMP3013SFV; Diodes_PowerDI3333-8
R11: 11k; R_0603_1608Metric
R12: 3k; R_0603_1608Metric
R13, R22, R23: 12k; R_0603_1608Metric
R14, R16: 4.7k; R_0603_1608Metric
R15: 30k; R_0603_1608Metric
R17, R20, R21: 62k; R_0603_1608Metric
R18: 18k; R_0603_1608Metric
R19: 1.6k; R_0603_1608Metric
R24: 10k; R_0603_1608Metric
U2: TPS54331; SOIC-8_3.9x4.9mm_P1.27mm
U3, U4, U5: RT8259; SOT-23-6_Handsoldering

Connections:
+3.3V: C40.1, C41.1, C42.1, L2.2, R17.1
+3V8: C20.2, C21.2, C22.2, C23.2, L1.2, R11.2
+5V: C52.1, C53.1, C54.1, L4.2, R21.1
+12V: C24.1, C25.2, C26.2, C27.2, C29.2, C30.2, C31.2, C32.2, C33.2, C38.1, C39.1, C45.1, C46.1, C50.1, C51.1, D12.3 (K), Q1.1 (S), Q1.2 (S), Q1.3 (S), U2.2 (VIN), U3.4 (EN), U3.5 (VIN), U4.5 (VIN), U5.4 (EN), U5.5 (VIN)
+12VA: C28.1, D13.1 (A1), J2.1, Q1.5 (D)
Display_Enable: R24.1, U4.4 (EN)
Display_VCC: C47.1, C48.1, C49.1, L3.2, R20.1
GND: C20.1, C21.1, C22.1, C23.1, C25.1, C26.1, C27.1, C28.2, C29.1, C30.1, C31.1, C32.1, C33.1, C34.1, C36.1, C38.2, C39.2, C40.2, C41.2, C42.2, C45.2, C46.2, C47.2, C48.2, C49.2, C50.2, C51.2, C52.2, C53.2, C54.2, D11.2 (A), D13.2 (A2), D14.2 (A), D15.2 (A), D16.2 (A), J2.2, J2.3, R12.1, R13.2, R15.1, R16.1, R19.2, R22.2, R23.2, R24.2, U2.7 (GND), U3.2 (GND), U4.2 (GND), U5.2 (GND)
LTE_En: R14.2
unnamed: C19.1, U2.1 (BOOT)
unnamed: C19.2, D11.1 (K), L1.1, U2.8 (PH)
unnamed: C24.2, D12.1 (A), Q1.4 (G), R13.1
unnamed: C34.2, U2.4 (SS)
unnamed: C35.1, R15.2
unnamed: C35.2, C36.2, U2.6 (COMP)
unnamed: C37.1, U3.1 (BOOT)
unnamed: C37.2, D14.1 (K), L2.1, U3.6 (PHASE)
unnamed: C43.1, U4.1 (BOOT)
unnamed: C43.2, D15.1 (K), L3.1, U4.6 (PHASE)
unnamed: C44.1, U5.1 (BOOT)
unnamed: C44.2, D16.1 (K), L4.1, U5.6 (PHASE)
unnamed: R11.1, R12.2, U2.5 (FB)
unnamed: R14.1, R16.2, U2.3 (EN)
unnamed: R17.2, R18.1, U3.3 (FB)
unnamed: R18.2, R19.1
unnamed: R20.2, R22.1, U4.3 (FB)
unnamed: R21.2, R23.1, U5.3 (FB)

Notes on the sheet:
5v 1.2A
3.3v 1.2A
12v
3.8v 3.3A
