AleksandreKalandadze/GateWay_STM32/GateWay_ver_2_3/PCB/Gateway_STM32_ver_2_3/RS-232.kicad_sch

## KiCad design GateWay_ver_2_3/PCB/Gateway_STM32_ver_2_3/RS-232.kicad_sch (2022-02-23)

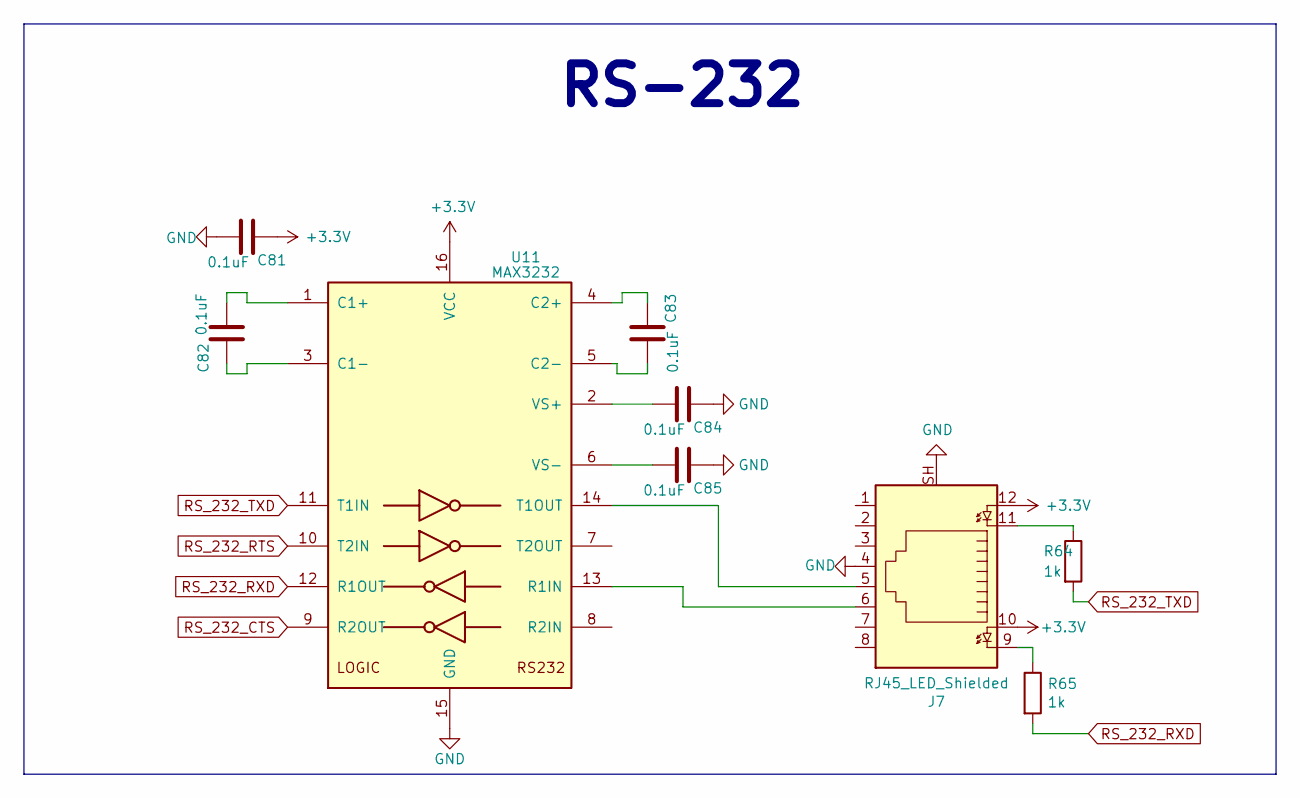
[picture p23: schematic RS-232.kicad_sch]

Parts:
C81, C82, C83, C84, C85: 0.1uF; C_0603_1608Metric
J7: RJ45_LED_Shielded; RJ45_Amphenol_RJHSE538X
R64, R65: 1k; R_0603_1608Metric
U11: MAX3232; SOP-16_3.9x9.9mm_P1.27mm

Connections:
+3.3V: C81.1, J7.10, J7.12, U11.16 (VCC)
GND: C81.2, C84.1, C85.1, J7.4, J7.SH, U11.15 (GND)
unnamed: C82.1, U11.3 (C1-)
unnamed: C82.2, U11.1 (C1+)
unnamed: C83.1, U11.4 (C2+)
unnamed: C83.2, U11.5 (C2-)
unnamed: C84.2, U11.2 (VS+)
unnamed: C85.2, U11.6 (VS-)
unnamed: J7.5, U11.14 (T1OUT)
unnamed: J7.6, U11.13 (R1IN)
unnamed: J7.9, R65.1
unnamed: J7.11, R64.1
RS_232_CTS: U11.9 (R2OUT)
RS_232_RTS: U11.10 (T2IN)
RS_232_RXD: R65.2, U11.12 (R1OUT)
RS_232_TXD: R64.2, U11.11 (T1IN)

Notes on the sheet:
RS-232
