AleksandreKalandadze/GateWay_STM32/GateWay_ver_2_3/PCB/Gateway_STM32_ver_2_3/RS-485 & 232.kicad_sch

## KiCad design GateWay_ver_2_3/PCB/Gateway_STM32_ver_2_3/RS-485 & 232.kicad_sch (2022-04-11)

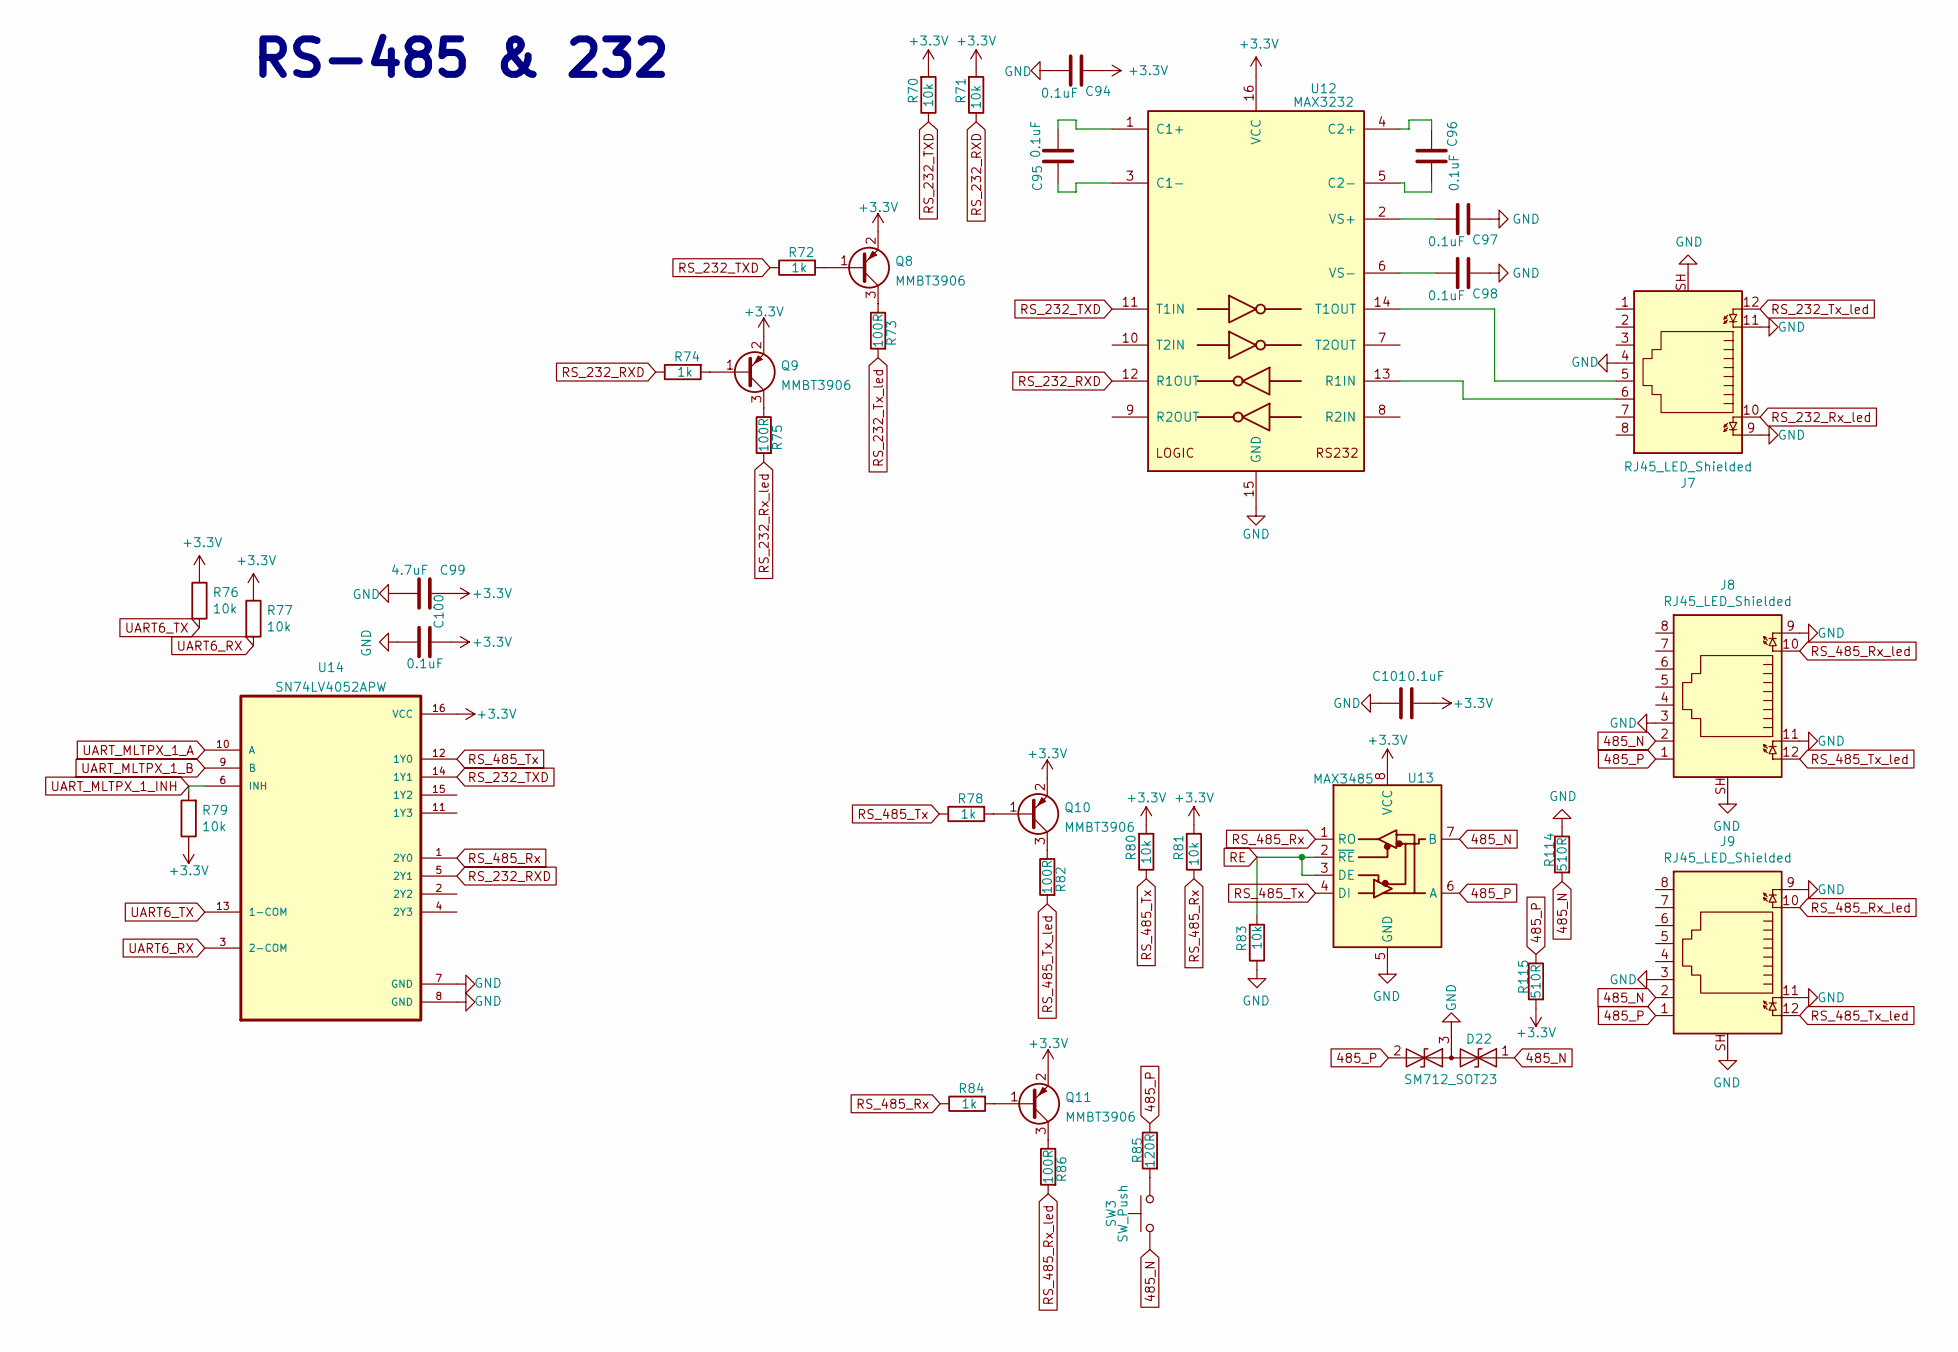
[picture p24: schematic RS-485 & 232.kicad_sch]

Parts:
C94, C95, C96, C97, C98, C100, C101: 0.1uF; C_0603_1608Metric
C99: 4.7uF; C_0805_2012Metric
D22: SM712_SOT23; SOT-23
J7, J8, J9: RJ45_LED_Shielded; RJ45_Amphenol_RJHSE538X
Q8, Q9, Q10, Q11: MMBT3906; SOT-23
R70, R71, R76, R77, R79, R80, R81, R83: 10k; R_0603_1608Metric
R72, R74, R78, R84: 1k; R_0603_1608Metric
R73, R75, R82, R86: 100R; R_0603_1608Metric
R85: 120R; R_0603_1608Metric
R114, R115: 510R; R_0603_1608Metric
SW3: SW_Push; SW_DIP_SPSTx01_Slide_9.78x4.72mm_W7.62mm_P2.54mm
U12: MAX3232; SOP-16_3.9x9.9mm_P1.27mm
U13: MAX3485; SOIC-8_3.9x4.9mm_P1.27mm
U14: SN74LV4052APW; TSSOP-16_4.4x5mm_P0.65mm

Connections:
485_N: D22.1 (A1), J8.2, J9.2, R114.2, SW3.2, U13.7 (B)
485_P: D22.2 (A2), J8.1, J9.1, R85.1, R115.1, U13.6 (A)
+3.3V: C94.1, C99.1, C100.2, C101.1, Q8.2 (E), Q9.2 (E), Q10.2 (E), Q11.2 (E), R70.2, R71.2, R76.1, R77.1, R79.1, R80.2, R81.2, R115.2, U12.16 (VCC), U13.8 (VCC), U14.16 (VCC)
GND: C94.2, C97.1, C98.1, C99.2, C100.1, C101.2, D22.3 (common), J7.4, J7.9, J7.11, J7.SH, J8.3, J8.9, J8.11, J8.SH, J9.3, J9.9, J9.11, J9.SH, R83.1, R114.1, U12.15 (GND), U13.5 (GND), U14.7 (GND), U14.8 (GND)
unnamed: C95.1, U12.3 (C1-)
unnamed: C95.2, U12.1 (C1+)
unnamed: C96.1, U12.4 (C2+)
unnamed: C96.2, U12.5 (C2-)
unnamed: C97.2, U12.2 (VS+)
unnamed: C98.2, U12.6 (VS-)
unnamed: J7.5, U12.14 (T1OUT)
unnamed: J7.6, U12.13 (R1IN)
unnamed: Q8.1 (B), R72.2
unnamed: Q8.3 (C), R73.1
unnamed: Q9.1 (B), R74.2
unnamed: Q9.3 (C), R75.1
unnamed: Q10.1 (B), R78.2
unnamed: Q10.3 (C), R82.1
unnamed: Q11.1 (B), R84.2
unnamed: Q11.3 (C), R86.1
unnamed: R85.2, SW3.1
RE: R83.2, U13.2 (~RE), U13.3 (DE)
RS_232_RXD: R71.1, R74.1, U12.12 (R1OUT), U14.5 (2Y1)
RS_232_Rx_led: J7.10, R75.2
RS_232_TXD: R70.1, R72.1, U12.11 (T1IN), U14.14 (1Y1)
RS_232_Tx_led: J7.12, R73.2
RS_485_Rx: R81.1, R84.1, U13.1 (RO), U14.1 (2Y0)
RS_485_Rx_led: J8.10, J9.10, R86.2
RS_485_Tx: R78.1, R80.1, U13.4 (DI), U14.12 (1Y0)
RS_485_Tx_led: J8.12, J9.12, R82.2
UART6_RX: R77.2, U14.3 (2-COM)
UART6_TX: R76.2, U14.13 (1-COM)
UART_MLTPX_1_A: U14.10 (A)
UART_MLTPX_1_B: U14.9 (B)
UART_MLTPX_1_INH: R79.2, U14.6 (INH)

Notes on the sheet:
RS-485 & 232
