AleksandreKalandadze/GateWay_STM32/GateWay_ver_2_3/PCB/Gateway_STM32_ver_2_3/RS-485.kicad_sch

## KiCad design GateWay_ver_2_3/PCB/Gateway_STM32_ver_2_3/RS-485.kicad_sch (2022-02-23)

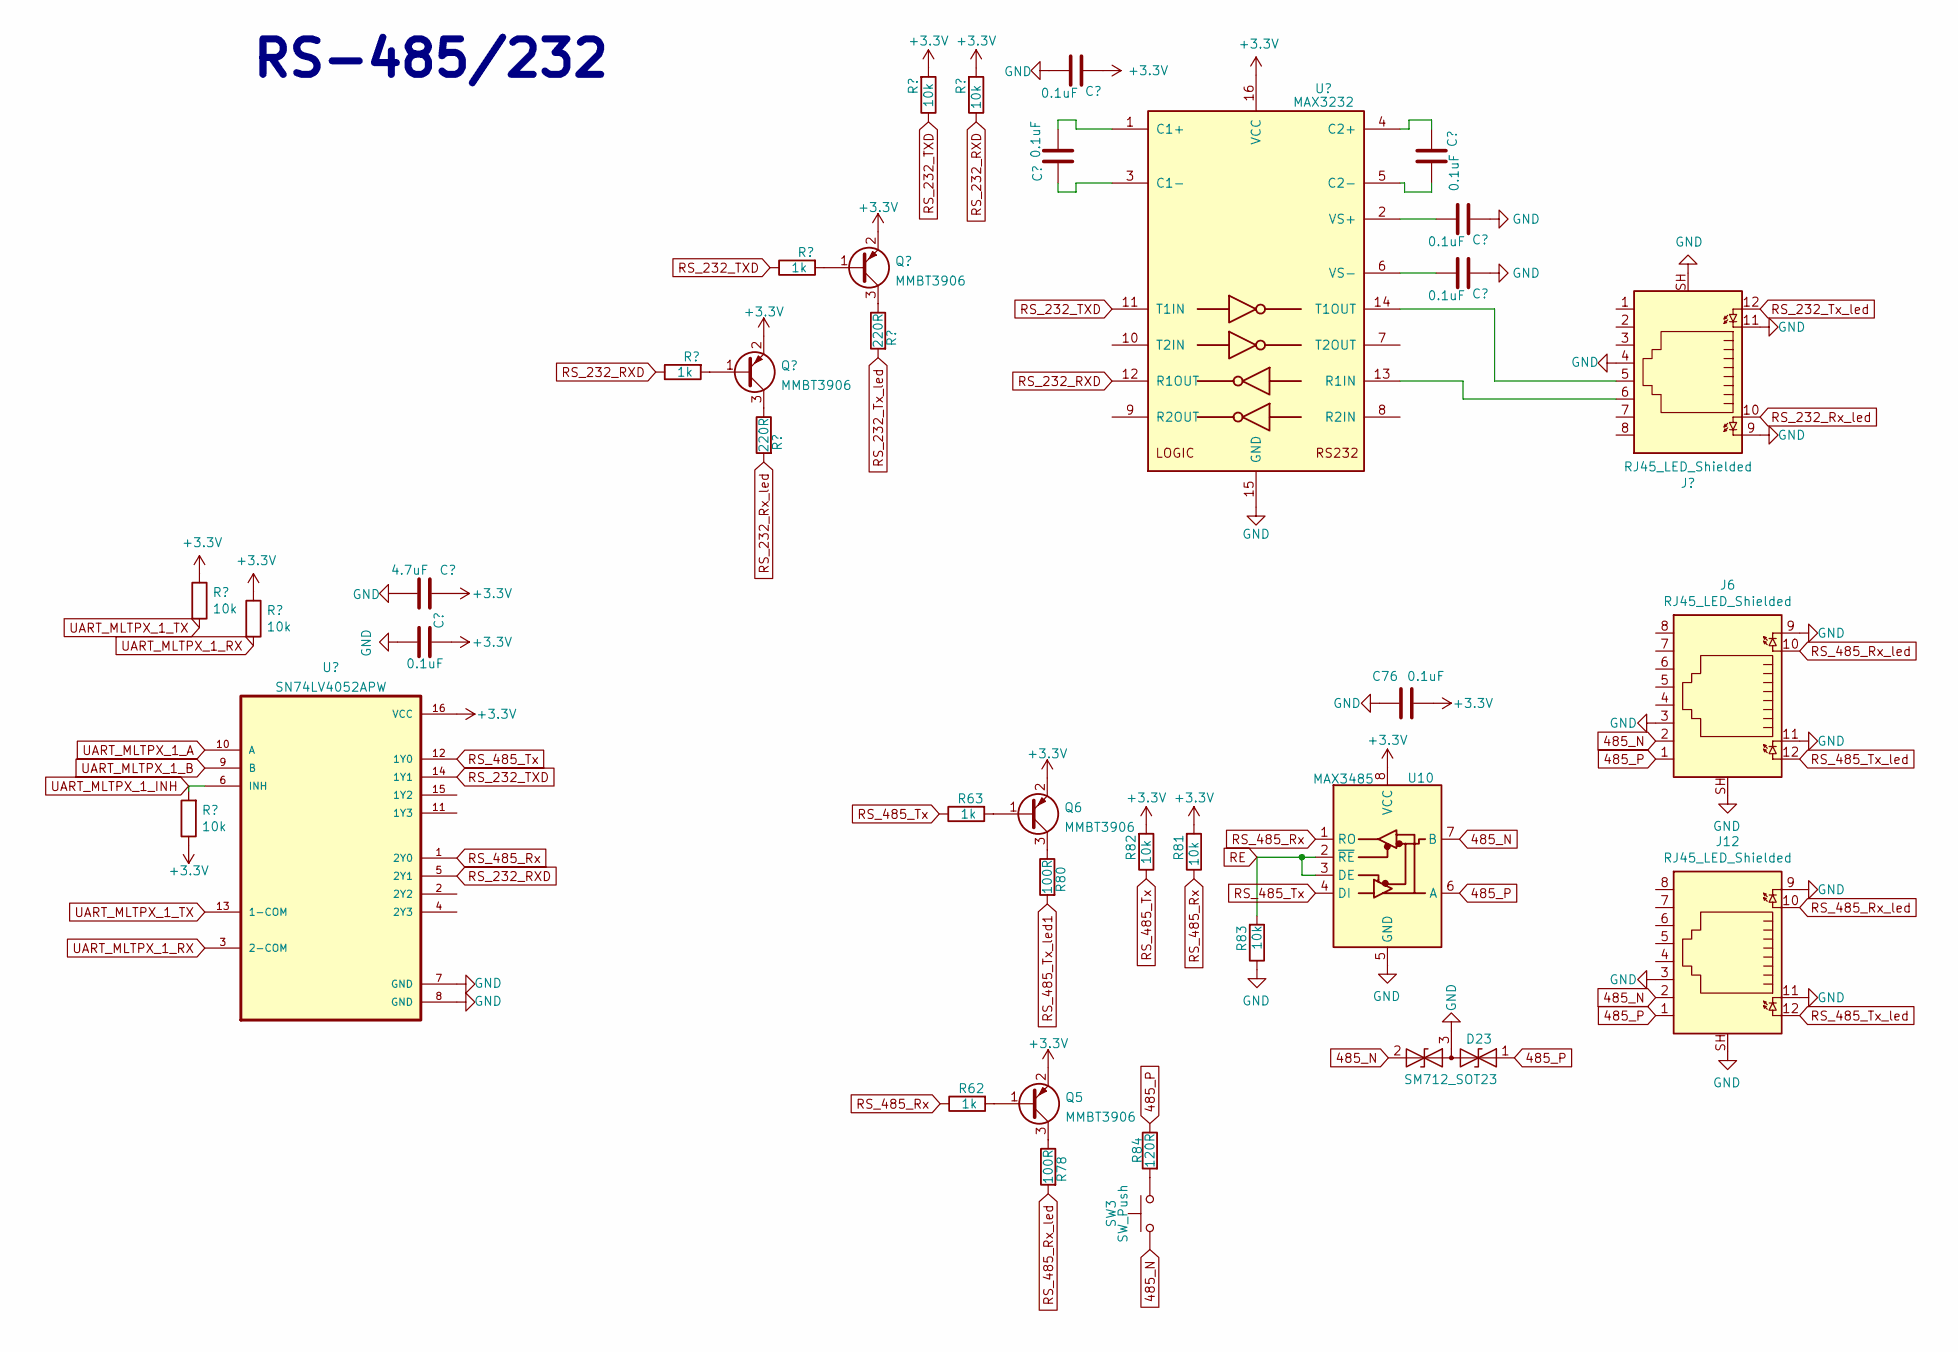
[picture p25: schematic RS-485.kicad_sch]

Parts:
C76: 0.1uF; C_0603_1608Metric
D23: SM712_SOT23; SOT-23
J6, J12: RJ45_LED_Shielded; RJ45_Amphenol_RJHSE538X
Q5, Q6: MMBT3906; SOT-23
R62, R63: 1k; R_0603_1608Metric
R78, R80: 100R; R_0603_1608Metric
R81, R82, R83: 10k; R_0603_1608Metric
R84: 120R; R_0603_1608Metric
SW3: SW_Push; SW_DIP_SPSTx01_Slide_9.78x4.72mm_W7.62mm_P2.54mm
U10: MAX3485; SOIC-8_3.9x4.9mm_P1.27mm

Connections:
485_N: D23.2 (A2), J6.2, J12.2, SW3.2, U10.7 (B)
485_P: D23.1 (A1), J6.1, J12.1, R84.1, U10.6 (A)
+3.3V: C76.1, Q5.2 (E), Q6.2 (E), R81.2, R82.2, U10.8 (VCC)
GND: C76.2, D23.3 (common), J6.3, J6.9, J6.11, J6.SH, J12.3, J12.9, J12.11, J12.SH, R83.1, U10.5 (GND)
unnamed: Q5.1 (B), R62.2
unnamed: Q5.3 (C), R78.1
unnamed: Q6.1 (B), R63.2
unnamed: Q6.3 (C), R80.1
unnamed: R84.2, SW3.1
RE: R83.2, U10.2 (~RE), U10.3 (DE)
RS_485_Rx: R62.1, R81.1, U10.1 (RO)
RS_485_Rx_led: J6.10, J12.10, R78.2
RS_485_Tx: R63.1, R82.1, U10.4 (DI)
RS_485_Tx_led: J6.12, J12.12
RS_485_Tx_led1: R80.2

Notes on the sheet:
RS-485/232
