AleksandreKalandadze/GateWay_STM32/GateWay_ver_2_3/PCB/Gateway_STM32_ver_2_3/SD Card.kicad_sch

## KiCad design GateWay_ver_2_3/PCB/Gateway_STM32_ver_2_3/SD Card.kicad_sch (2022-04-11)

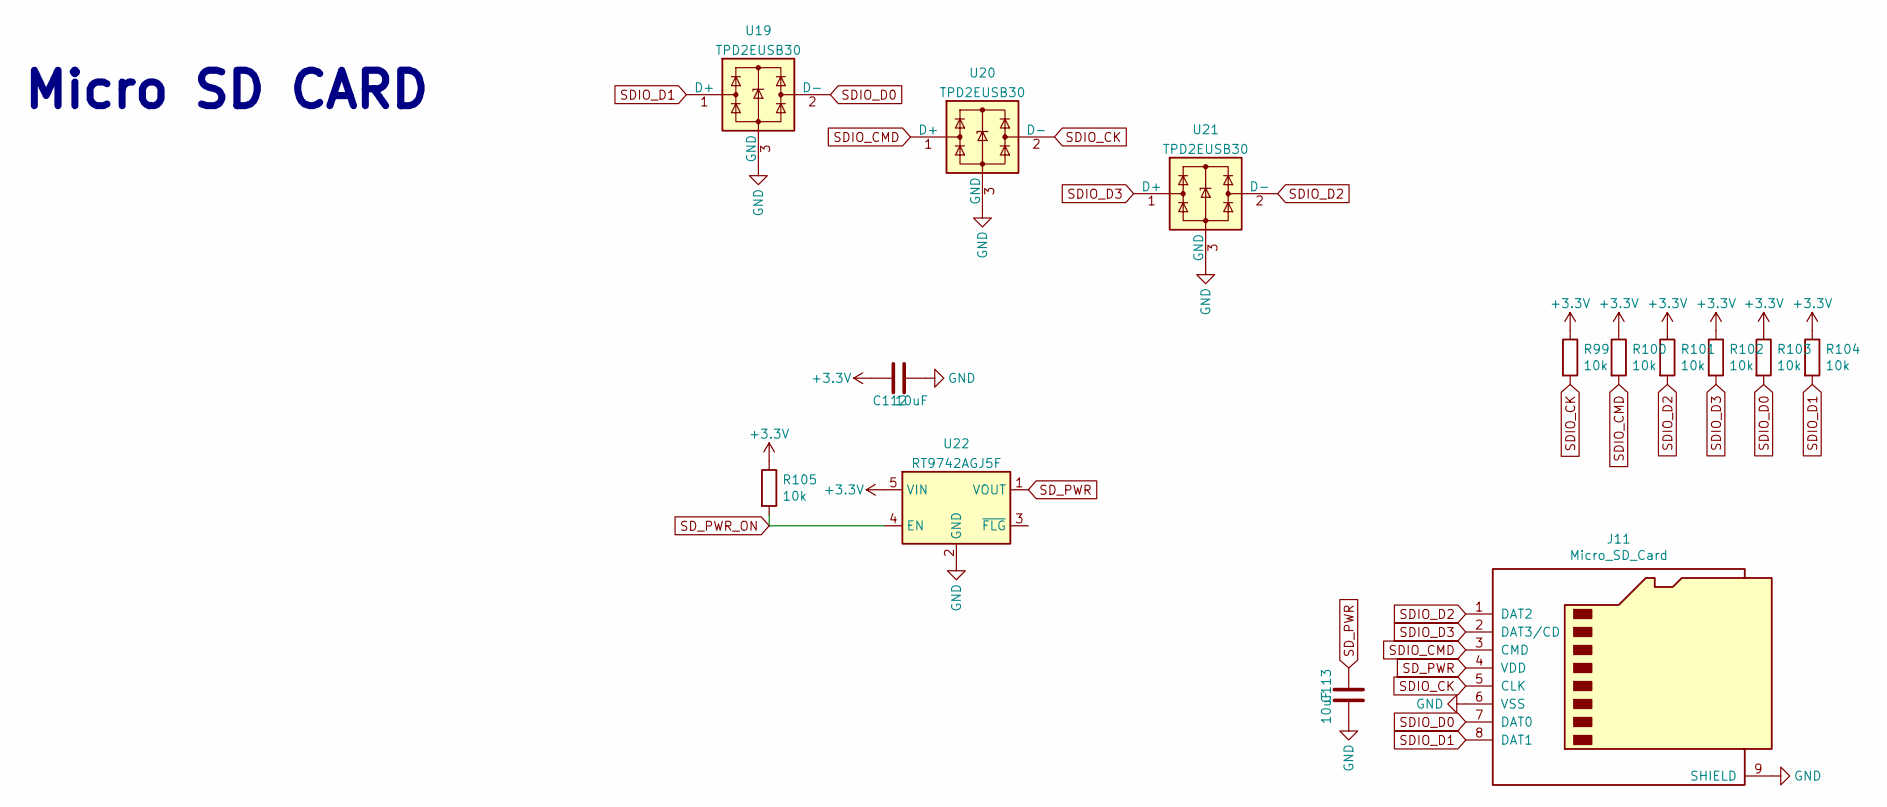
[picture p26: schematic SD Card.kicad_sch]

Parts:
C112, C113: 10uF; C_0805_2012Metric
J11: Micro_SD_Card; SD_Card_Holder_1
R99, R100, R101, R102, R103, R104, R105: 10k; R_0603_1608Metric
U19, U20, U21: TPD2EUSB30; Texas_DRT-3
U22: RT9742AGJ5F; TSOT-23-5

Connections:
+3.3V: C112.2, R99.1, R100.1, R101.1, R102.1, R103.1, R104.1, R105.1, U22.5 (VIN)
GND: C112.1, C113.1, J11.6 (VSS), J11.9 (SHIELD), U19.3 (GND), U20.3 (GND), U21.3 (GND), U22.2 (GND)
SDIO_CK: J11.5 (CLK), R99.2, U20.2 (D-)
SDIO_CMD: J11.3 (CMD), R100.2, U20.1 (D+)
SDIO_D0: J11.7 (DAT0), R103.2, U19.2 (D-)
SDIO_D1: J11.8 (DAT1), R104.2, U19.1 (D+)
SDIO_D2: J11.1 (DAT2), R101.2, U21.2 (D-)
SDIO_D3: J11.2 (DAT3/CD), R102.2, U21.1 (D+)
SD_PWR: C113.2, J11.4 (VDD), U22.1 (VOUT)
SD_PWR_ON: R105.2, U22.4 (EN)

Notes on the sheet:
Micro SD CARD
