AleksandreKalandadze/GateWay_STM32/GateWay_ver_2_3/PCB/Gateway_STM32_ver_2_3/Temperature.kicad_sch

## KiCad design GateWay_ver_2_3/PCB/Gateway_STM32_ver_2_3/Temperature.kicad_sch (2022-04-11)

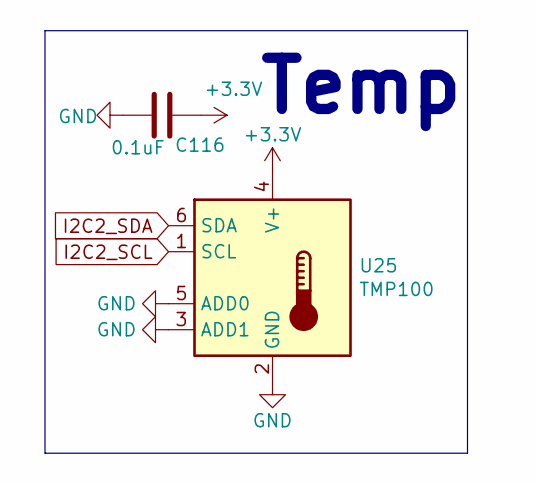
[picture p27: schematic Temperature.kicad_sch]

Parts:
C116: 0.1uF; C_0603_1608Metric
U25: TMP100; SOT-23-6

Connections:
+3.3V: C116.1, U25.4 (V+)
GND: C116.2, U25.2 (GND), U25.3 (ADD1), U25.5 (ADD0)
I2C2_SCL: U25.1 (SCL)
I2C2_SDA: U25.6 (SDA)

Notes on the sheet:
Temp
