AleksandreKalandadze/GateWay_STM32/GateWay_ver_2_3/PCB/Gateway_STM32_ver_2_3/USB.kicad_sch

## KiCad design GateWay_ver_2_3/PCB/Gateway_STM32_ver_2_3/USB.kicad_sch (2022-05-21)

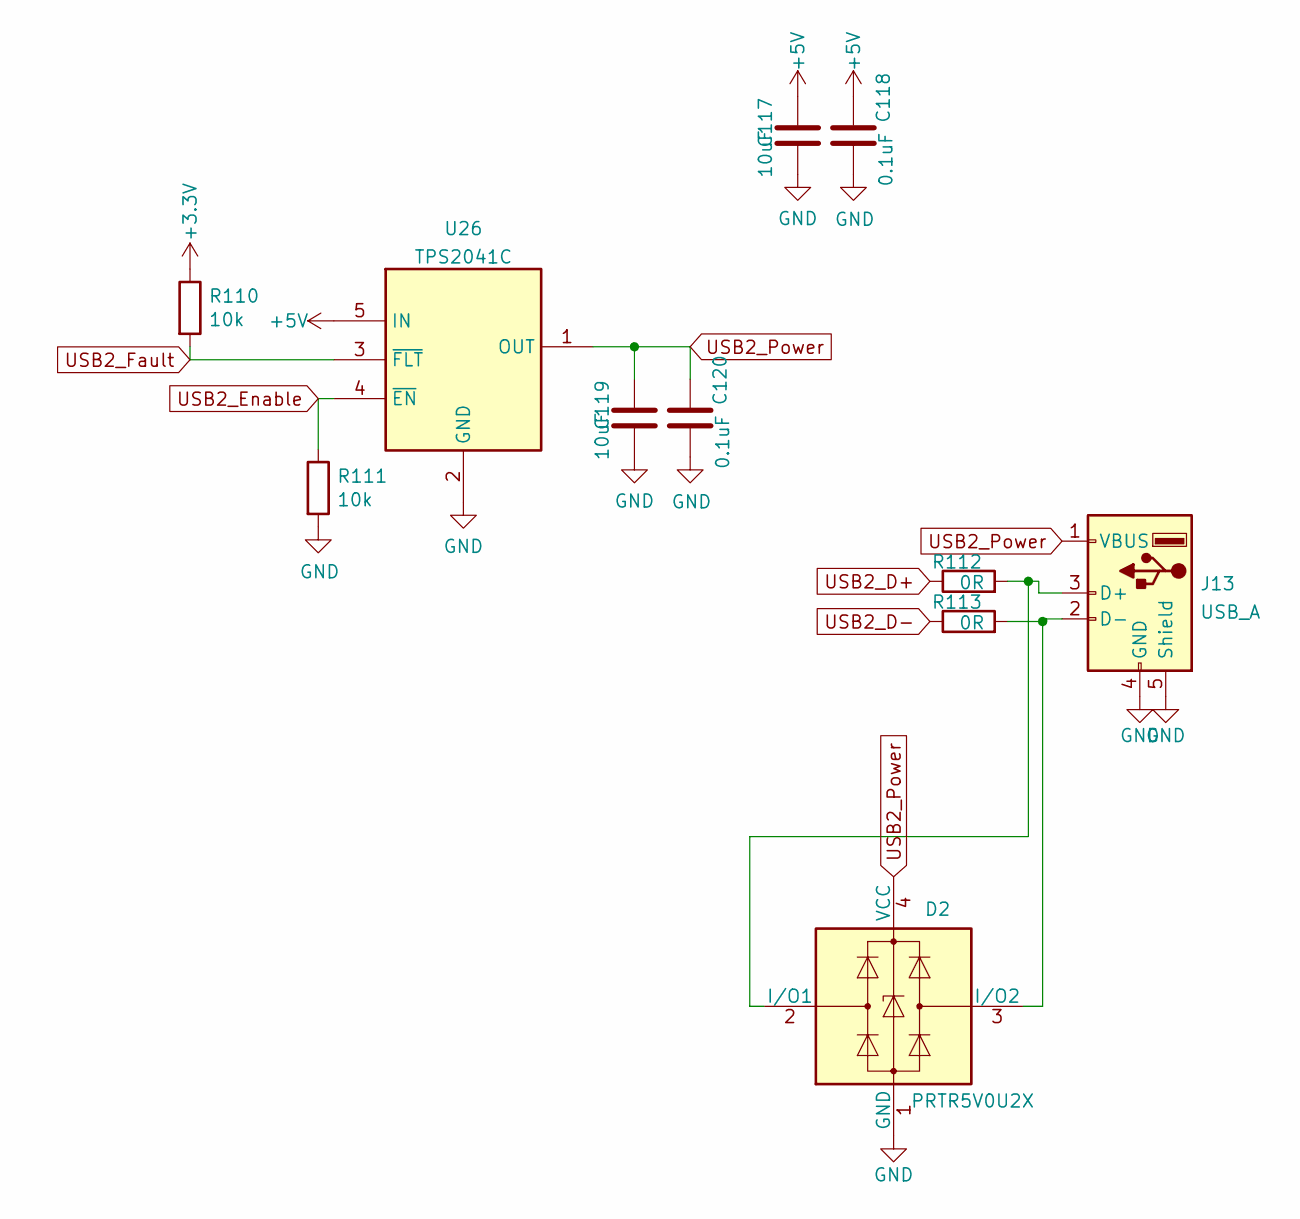
[picture p28: schematic USB.kicad_sch]

Parts:
C117, C119: 10uF; C_0805_2012Metric
C118, C120: 0.1uF; C_0603_1608Metric
D2: PRTR5V0U2X; SOT-143
J13: USB_A; USB_A_Wuerth_614004134726_Horizontal
R110, R111: 10k; R_0603_1608Metric
R112, R113: 0R; R_0603_1608Metric
U26: TPS2041C; SOT-23-5

Connections:
+3.3V: R110.1
+5V: C117.2, C118.1, U26.5 (IN)
GND: C117.1, C118.2, C119.1, C120.2, D2.1 (GND), J13.4 (GND), J13.5 (Shield), R111.2, U26.2 (GND)
unnamed: D2.2 (I/O1), J13.3 (D+), R112.2
unnamed: D2.3 (I/O2), J13.2 (D-), R113.2
USB2_D+: R112.1
USB2_D-: R113.1
USB2_Enable: R111.1, U26.4 (~EN)
USB2_Fault: R110.2, U26.3 (~FLT)
USB2_Power: C119.2, C120.1, D2.4 (VCC), J13.1 (VBUS), U26.1 (OUT)
