AleksandreKalandadze/GateWay_STM32/GateWay_ver_2_3/PCB/Gateway_STM32_ver_2_3/WIFI.kicad_sch

## KiCad design GateWay_ver_2_3/PCB/Gateway_STM32_ver_2_3/WIFI.kicad_sch (2022-04-11)

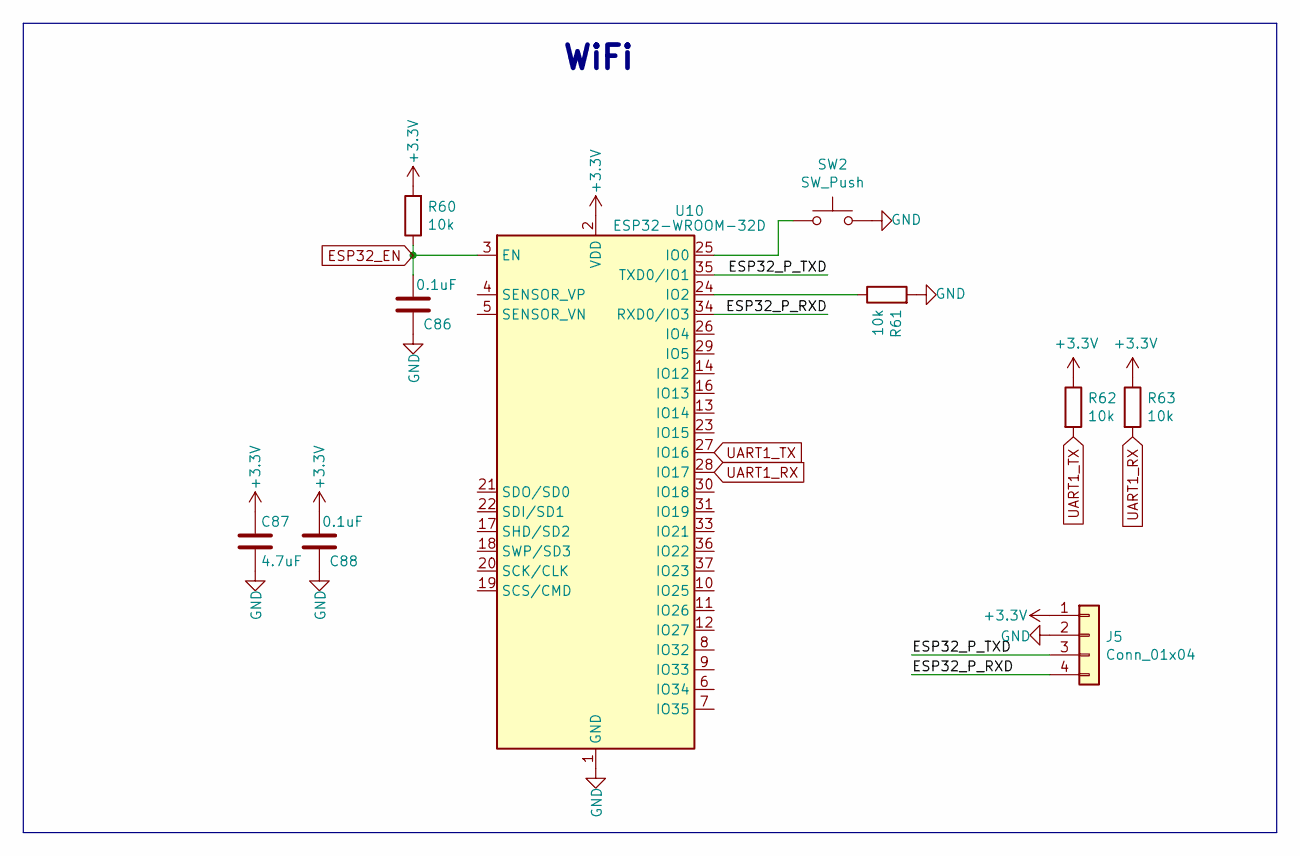
[picture p29: schematic WIFI.kicad_sch]

Parts:
C86, C88: 0.1uF; C_0603_1608Metric
C87: 4.7uF; C_0805_2012Metric
J5: Conn_01x04; PinHeader_1x04_P1.27mm_Vertical
R60, R61, R62, R63: 10k; R_0603_1608Metric
SW2: SW_Push; SW_SPST_CK_RS282G05A3
U10: ESP32-WROOM-32D

Connections:
+3.3V: C87.1, C88.2, J5.1, R60.2, R62.1, R63.1, U10.2 (VDD)
ESP32_EN: C86.2, R60.1, U10.3 (EN)
ESP32_P_RXD: J5.4, U10.34 (RXD0/IO3)
ESP32_P_TXD: J5.3, U10.35 (TXD0/IO1)
GND: C86.1, C87.2, C88.1, J5.2, R61.2, SW2.2, U10.1 (GND), U10.15 (GND), U10.38 (GND), U10.39 (GND)
unnamed: R61.1, U10.24 (IO2)
unnamed: SW2.1, U10.25 (IO0)
UART1_RX: R63.2, U10.28 (IO17)
UART1_TX: R62.2, U10.27 (IO16)

Notes on the sheet:
WiFi
