AleksandreKalandadze/GateWay_STM32/GateWay_ver_2_3/Software/Core/Src/main.c

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
/* Includes ------------------------------------------------------------------*/
#include "main.h"

/* USER CODE BEGIN Includes */
#include <stdio.h>
#include <string.h>
/* USER CODE END Includes */

/* USER CODE BEGIN PD */


#define INH_LOW HAL_GPIO_WritePin(GPIOE, GPIO_PIN_13, GPIO_PIN_RESET)
#define INH_HIGH HAL_GPIO_WritePin(GPIOE, GPIO_PIN_13, GPIO_PIN_SET)

#define MULTIPLEXER_A_LOW HAL_GPIO_WritePin(GPIOE, GPIO_PIN_15, GPIO_PIN_RESET)
#define MULTIPLEXER_A_HIGH HAL_GPIO_WritePin(GPIOE, GPIO_PIN_15, GPIO_PIN_SET)

#define MULTIPLEXER_B_LOW HAL_GPIO_WritePin(GPIOE, GPIO_PIN_14, GPIO_PIN_RESET)
#define MULTIPLEXER_B_HIGH HAL_GPIO_WritePin(GPIOE, GPIO_PIN_14, GPIO_PIN_SET)

#define RE_LOW    HAL_GPIO_WritePin(GPIOE, GPIO_PIN_12, GPIO_PIN_RESET)
#define RE_HIGH 	HAL_GPIO_WritePin(GPIOE, GPIO_PIN_12, GPIO_PIN_SET)


#define BLE_Mode_Data				HAL_GPIO_WritePin(GPIOD,GPIO_PIN_4, GPIO_PIN_RESET)
#define BLE_Mode_AT					HAL_GPIO_WritePin(GPIOD,GPIO_PIN_4, GPIO_PIN_SET)


#define BLE_RESET_ON		HAL_GPIO_WritePin(GPIOA,GPIO_PIN_8, GPIO_PIN_RESET)
#define BLE_RESET_OFF		HAL_GPIO_WritePin(GPIOA,GPIO_PIN_8, GPIO_PIN_SET)


#define ESP32_ON		HAL_GPIO_WritePin(GPIOC,GPIO_PIN_3, GPIO_PIN_SET)
#define ESP32_OFF	  HAL_GPIO_WritePin(GPIOC,GPIO_PIN_3, GPIO_PIN_RESET)


#define LTE_Enable  HAL_GPIO_WritePin(GPIOD,GPIO_PIN_15, GPIO_PIN_SET)
#define LTE_Disable HAL_GPIO_WritePin(GPIOD,GPIO_PIN_15, GPIO_PIN_RESET)

#define W5500_ON	  HAL_GPIO_WritePin(GPIOC,GPIO_PIN_5, GPIO_PIN_SET)
#define W5500_OFF		HAL_GPIO_WritePin(GPIOC,GPIO_PIN_5, GPIO_PIN_RESET)

/* USER CODE END PD */

I2C_HandleTypeDef hi2c1;

SPI_HandleTypeDef hspi1;
SPI_HandleTypeDef hspi2;
SPI_HandleTypeDef hspi3;

UART_HandleTypeDef huart4;
UART_HandleTypeDef huart5;
UART_HandleTypeDef huart1;
UART_HandleTypeDef huart2;
UART_HandleTypeDef huart3;
UART_HandleTypeDef huart6;

/* USER CODE BEGIN PV */
uint8_t Received_rx_byte[400] = {0};
uint8_t buffer_counter = 0;
uint8_t rx_buffer[250] = {0};

uint8_t transmit_buffer[50] = {0};


uint8_t Pair_status = 0;



const char *at_cwlap = "AT+CWLAP";

/* USER CODE END PV */

void SystemClock_Config(void);
static void MX_GPIO_Init(void);
static void MX_SPI1_Init(void);
static void MX_UART4_Init(void);
static void MX_USART1_UART_Init(void);
static void MX_USART2_UART_Init(void);
static void MX_USART3_UART_Init(void);
static void MX_USART6_UART_Init(void);
static void MX_I2C1_Init(void);
static void MX_SPI2_Init(void);
static void MX_UART5_Init(void);
static void MX_SPI3_Init(void);
/**
  * @brief  The application entry point.
  * @retval int
  */
int main(void)
{
  /* MCU Configuration--------------------------------------------------------*/

  /* Reset of all peripherals, Initializes the Flash interface and the Systick. */
  HAL_Init();

  /* Configure the system clock */
  SystemClock_Config();

  /* Initialize all configured peripherals */
  MX_GPIO_Init();
  MX_SPI1_Init();
  MX_UART4_Init();
  MX_USART1_UART_Init();
  MX_USART2_UART_Init();
  MX_USART3_UART_Init();
  MX_USART6_UART_Init();
  MX_I2C1_Init();
  MX_SPI2_Init();
  MX_UART5_Init();
  MX_SPI3_Init();
  /* USER CODE BEGIN 2 */
	HAL_GPIO_WritePin(GPIOE,GPIO_PIN_5,GPIO_PIN_SET); // Turn on 5V regulator
	HAL_UART_Receive_IT(&huart2, rx_buffer, 1);
	
	
	ESP32_OFF;
	HAL_Delay(500);
	ESP32_ON;
	HAL_Delay(500);
	HAL_Delay(2000);
	
	HAL_Delay(2000);
	
	
	
	transmit_buffer[0] = 'A';
	transmit_buffer[1] = 'T';
	transmit_buffer[2] = 0x0D;
	transmit_buffer[3] = 0x0A;
	
	HAL_UART_Transmit(&huart2,transmit_buffer,strlen((char*)transmit_buffer),100);
	HAL_Delay(500);
	__NOP();
	
	
	memset(Received_rx_byte,0,250);
	memset(transmit_buffer,0,50);
	buffer_counter = 0;
	__NOP();
	
	transmit_buffer[0] = 'A';
	transmit_buffer[1] = 'T';
	transmit_buffer[2] = 'E';
	transmit_buffer[3] = '0';
	transmit_buffer[4] = 0x0D;
	transmit_buffer[5] = 0x0A;
	
	HAL_UART_Transmit(&huart2,transmit_buffer,strlen((char*)transmit_buffer),100);
	HAL_Delay(500);
	__NOP();
	
	
	
	memset(Received_rx_byte,0,250);
	memset(transmit_buffer,0,50);
	buffer_counter = 0;
	__NOP();
	
	
	transmit_buffer[0] = 'A';
	transmit_buffer[1] = 'T';
	transmit_buffer[2] = '+';
	transmit_buffer[3] = 'S';
	transmit_buffer[4] = 'L';
	transmit_buffer[5] = 'E';
	transmit_buffer[6] = 'E';
	transmit_buffer[7] = 'P';
	transmit_buffer[8] = '=';
	transmit_buffer[9] = '0';
	transmit_buffer[10] = 0x0D;
	transmit_buffer[11] = 0x0A;
	
	
	__NOP();
	HAL_UART_Transmit(&huart2,transmit_buffer,strlen((char*)transmit_buffer),100);
	HAL_Delay(500);
	__NOP();
	
	
	
	memset(Received_rx_byte,0,250);
	memset(transmit_buffer,0,50);
	buffer_counter = 0;
	__NOP();
	
	
	
	transmit_buffer[0] = 'A';
	transmit_buffer[1] = 'T';
	transmit_buffer[2] = '+';
	transmit_buffer[3] = 'C';
	transmit_buffer[4] = 'W';
	transmit_buffer[5] = 'M';
	transmit_buffer[6] = 'O';
	transmit_buffer[7] = 'D';
	transmit_buffer[8] = 'E';
	transmit_buffer[9] = '=';
	transmit_buffer[10] = '1';
	transmit_buffer[11] = 0x0D;
	transmit_buffer[12] = 0x0A;
	
	__NOP();
	HAL_UART_Transmit(&huart2,transmit_buffer,strlen((char*)transmit_buffer),100);
	HAL_Delay(500);
	__NOP();
	
	
	
	memset(Received_rx_byte,0,250);
	memset(transmit_buffer,0,50);
	buffer_counter = 0;
	__NOP();
	
	
	
	transmit_buffer[0] = 'A';
	transmit_buffer[1] = 'T';
	transmit_buffer[2] = '+';
	transmit_buffer[3] = 'C';
	transmit_buffer[4] = 'W';
	transmit_buffer[5] = 'L';
	transmit_buffer[6] = 'A';
	transmit_buffer[7] = 'P';
	transmit_buffer[8] = '=';
	transmit_buffer[9] = '"';
	transmit_buffer[10] = 'M';
	transmit_buffer[11] = 'E';
	transmit_buffer[12] = 'A';
	transmit_buffer[13] = 'M';
	transmit_buffer[14] = 'A';
	transmit_buffer[15] = ' ';
	transmit_buffer[16] = 'H';
	transmit_buffer[17] = 'A';
	transmit_buffer[18] = 'R';
	transmit_buffer[19] = 'D';
	transmit_buffer[20] = 'W';
	transmit_buffer[21] = 'A';
	transmit_buffer[22] = 'R';
	transmit_buffer[23] = 'E';
	transmit_buffer[24] = '"';
	transmit_buffer[25] = 0x0D;
	transmit_buffer[26] = 0x0A;
	
	__NOP();
	HAL_UART_Transmit(&huart2,transmit_buffer,strlen((char*)transmit_buffer),100);
	HAL_Delay(5000);
	__NOP();
	
	
	memset(Received_rx_byte,0,250);
	memset(transmit_buffer,0,50);
	buffer_counter = 0;
	__NOP();
	
	
	
	transmit_buffer[0] = 'A';
	transmit_buffer[1] = 'T';
	transmit_buffer[2] = '+';
	transmit_buffer[3] = 'C';
	transmit_buffer[4] = 'W';
	transmit_buffer[5] = 'Q';
	transmit_buffer[6] = 'A';
	transmit_buffer[7] = 'P';
	transmit_buffer[8] = 0x0D;
	transmit_buffer[9] = 0x0A;
	
	__NOP();
	HAL_UART_Transmit(&huart2,transmit_buffer,strlen((char*)transmit_buffer),100);
	HAL_Delay(500);
	__NOP();

	
	memset(Received_rx_byte,0,250);
	memset(transmit_buffer,0,50);
	buffer_counter = 0;
	__NOP();
	

	
	
	transmit_buffer[0] = 'A';
	transmit_buffer[1] = 'T';
	transmit_buffer[2] = '+';
	transmit_buffer[3] = 'C';
	transmit_buffer[4] = 'W';
	transmit_buffer[5] = 'J';
	transmit_buffer[6] = 'A';
	transmit_buffer[7] = 'P';
	transmit_buffer[8] = '=';
	transmit_buffer[9] = '"';
	transmit_buffer[10] = 'M';
	transmit_buffer[11] = 'E';
	transmit_buffer[12] = 'A';
	transmit_buffer[13] = 'M';
	transmit_buffer[14] = 'A';
	transmit_buffer[15] = ' ';
	transmit_buffer[16] = 'H';
	transmit_buffer[17] = 'A';
	transmit_buffer[18] = 'R';
	transmit_buffer[19] = 'D';
	transmit_buffer[20] = 'W';
	transmit_buffer[21] = 'A';
	transmit_buffer[22] = 'R';
	transmit_buffer[23] = 'E';
	transmit_buffer[24] = '"';
	transmit_buffer[25] = ',';
	transmit_buffer[26] = '"';
	transmit_buffer[27] = 'm';
	transmit_buffer[28] = 'e';
	transmit_buffer[29] = 'a';
	transmit_buffer[30] = 'm';
	transmit_buffer[31] = 'a';
	transmit_buffer[32] = '2';
	transmit_buffer[33] = '0';
	transmit_buffer[34] = '2';
	transmit_buffer[35] = '0';
	transmit_buffer[36] = '2';
	transmit_buffer[37] = '0';
	transmit_buffer[38] = '"';
	transmit_buffer[39] = 0x0D;
	transmit_buffer[40] = 0x0A;
	
	__NOP();
	HAL_UART_Transmit(&huart2,transmit_buffer,strlen((char*)transmit_buffer),100);
	HAL_Delay(10000);
	__NOP();
	
	
	
	memset(Received_rx_byte,0,250);
	memset(transmit_buffer,0,50);
	buffer_counter = 0;
	__NOP();
	
	
	transmit_buffer[0] = 'A';
	transmit_buffer[1] = 'T';
	transmit_buffer[2] = '+';
	transmit_buffer[3] = 'C';
	transmit_buffer[4] = 'I';
	transmit_buffer[5] = 'F';
	transmit_buffer[6] = 'S';
	transmit_buffer[7] = 'R';
	transmit_buffer[8] = 0x0D;
	transmit_buffer[9] = 0x0A;
	
	__NOP();
	HAL_UART_Transmit(&huart2,transmit_buffer,strlen((char*)transmit_buffer),100);
	HAL_Delay(500);
	__NOP();

	
	memset(Received_rx_byte,0,250);
	memset(transmit_buffer,0,50);
	buffer_counter = 0;
	__NOP();
	
	
	/*
	transmit_buffer[0] = 'A';
	transmit_buffer[1] = 'T';
	transmit_buffer[2] = '+';
	transmit_buffer[3] = 'C';
	transmit_buffer[4] = 'W';
	transmit_buffer[5] = 'Q';
	transmit_buffer[6] = 'A';
	transmit_buffer[7] = 'P';
	transmit_buffer[8] = 0x0D;
	transmit_buffer[9] = 0x0A;
	
	__NOP();
	HAL_UART_Transmit(&huart2,transmit_buffer,strlen((char*)transmit_buffer),100);
	HAL_Delay(500);
	__NOP();*/
	
	
	

	
  /* USER CODE END 2 */

  /* Infinite loop */
  /* USER CODE BEGIN WHILE */
  while (1)
  {
    /* USER CODE END WHILE */

    /* USER CODE BEGIN 3 */
  }
  /* USER CODE END 3 */
}

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
/* USER CODE BEGIN 4 */

void HAL_UART_RxCpltCallback(UART_HandleTypeDef *huart)
{
	Received_rx_byte[buffer_counter] = rx_buffer[0];
	buffer_counter++;
	HAL_UART_Receive_IT(&huart2, rx_buffer, 1); //restart interrupt
}

/* USER CODE END 4 */
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
